sebastiandure33-crypto/Banco-de-pruebas-PID-v2/1_DISENO_3D/imagenes/01_vista_general.png

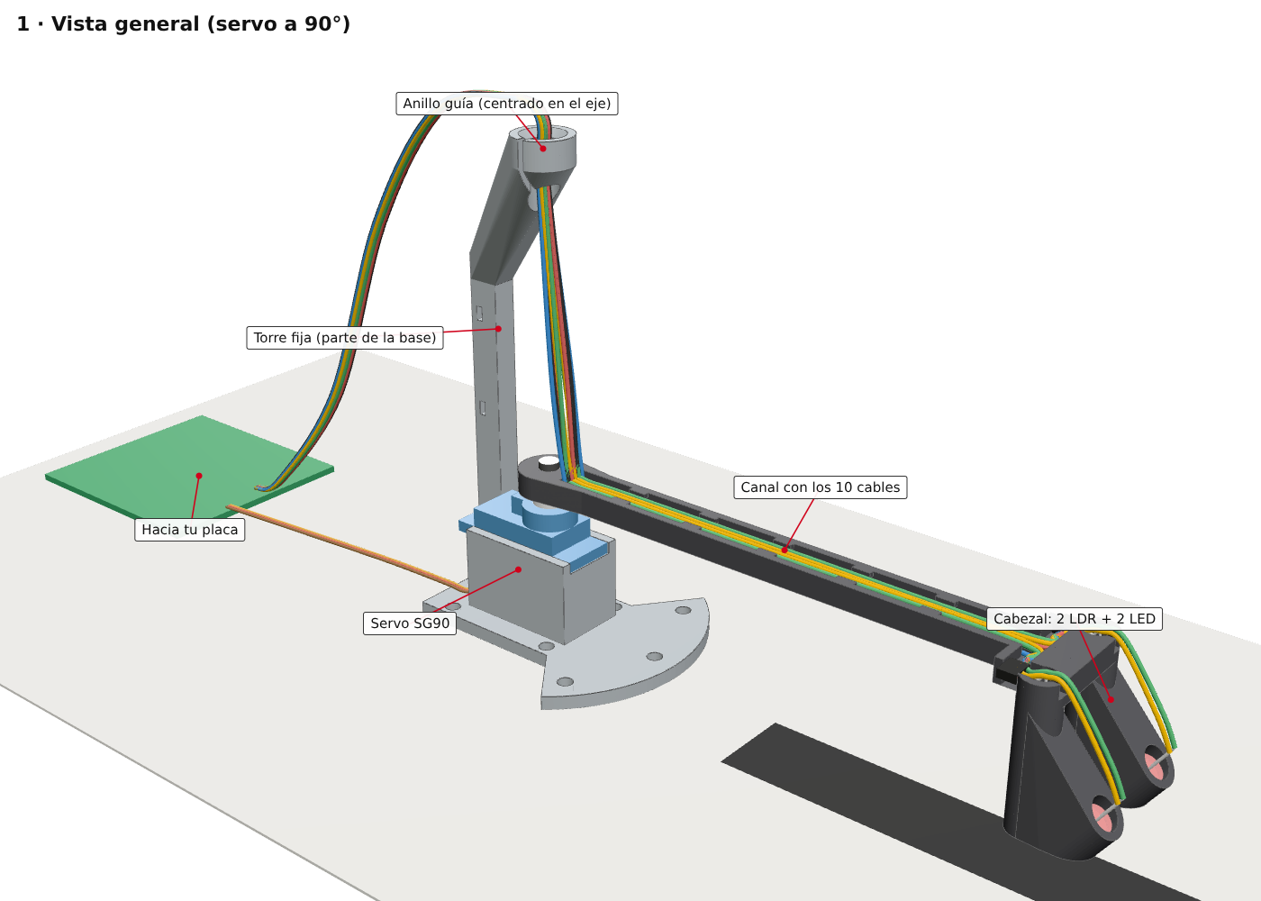
1_DISENO_3D/imagenes/01_vista_general.png
