sebastiandure33-crypto/Banco-de-pruebas-PID-v2/1_DISENO_3D/imagenes/02_vista_lateral.png

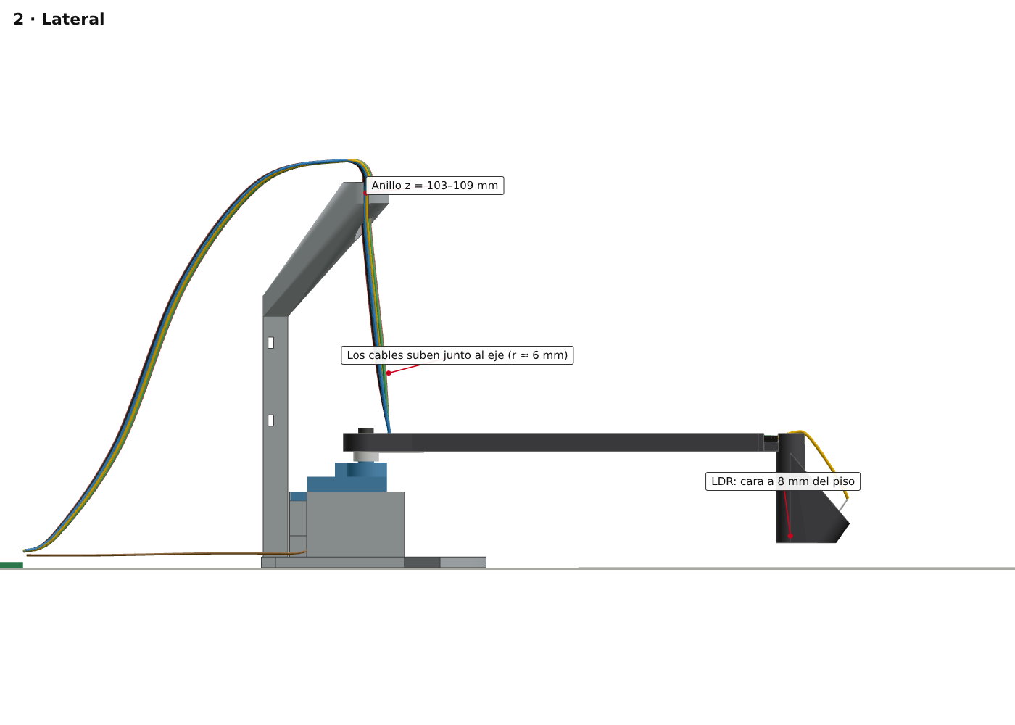
1_DISENO_3D/imagenes/02_vista_lateral.png
