sebastiandure33-crypto/Banco-de-pruebas-PID-v2/1_DISENO_3D/imagenes/04_cabezal.png

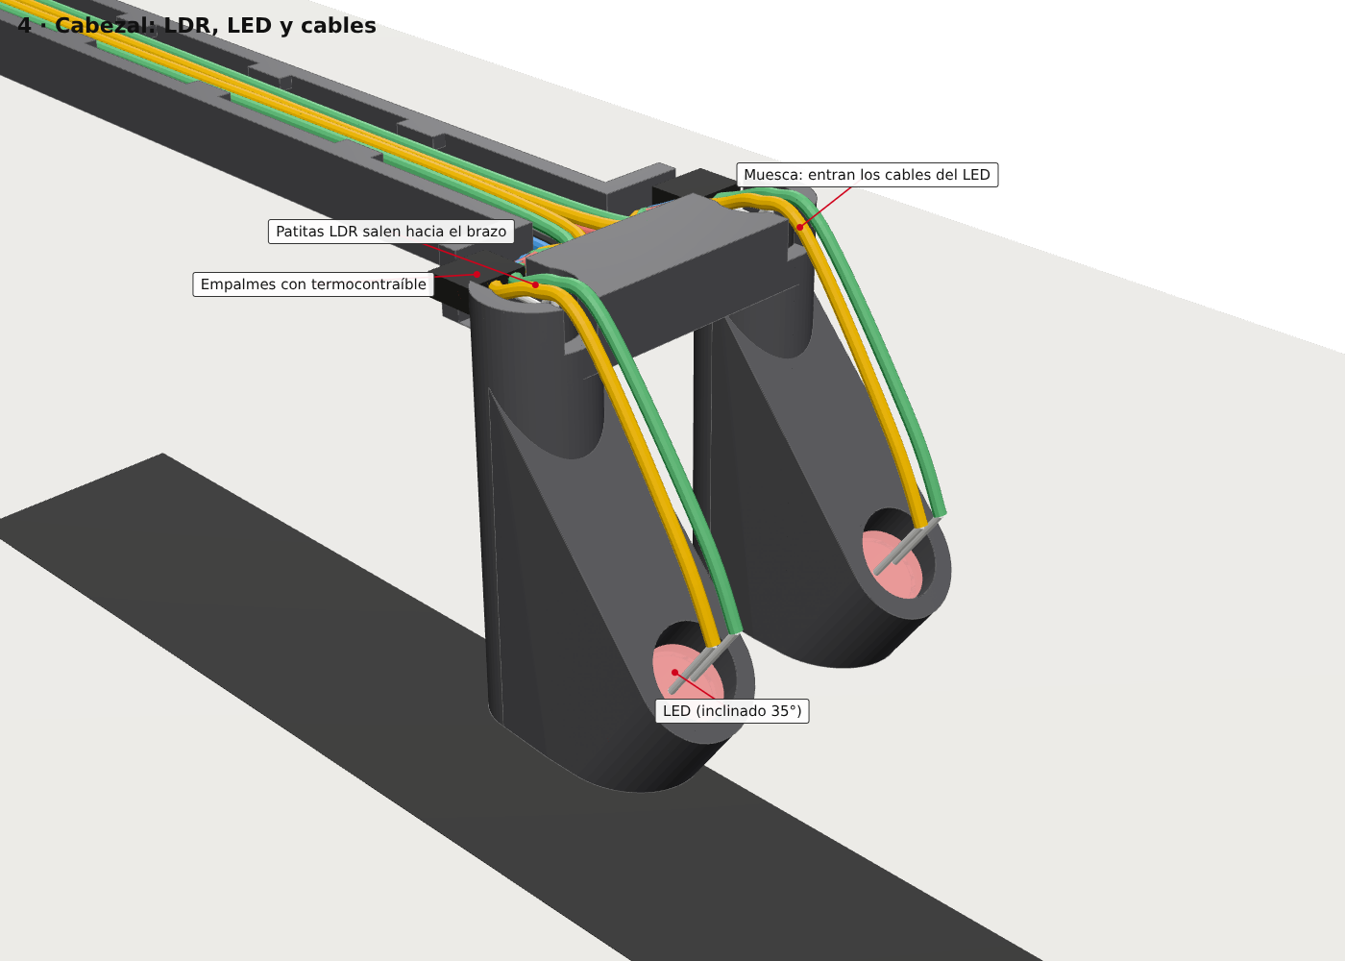
1_DISENO_3D/imagenes/04_cabezal.png
