sebastiandure33-crypto/Banco-de-pruebas-PID-v2/1_DISENO_3D/imagenes/05_cabezal_desde_abajo.png

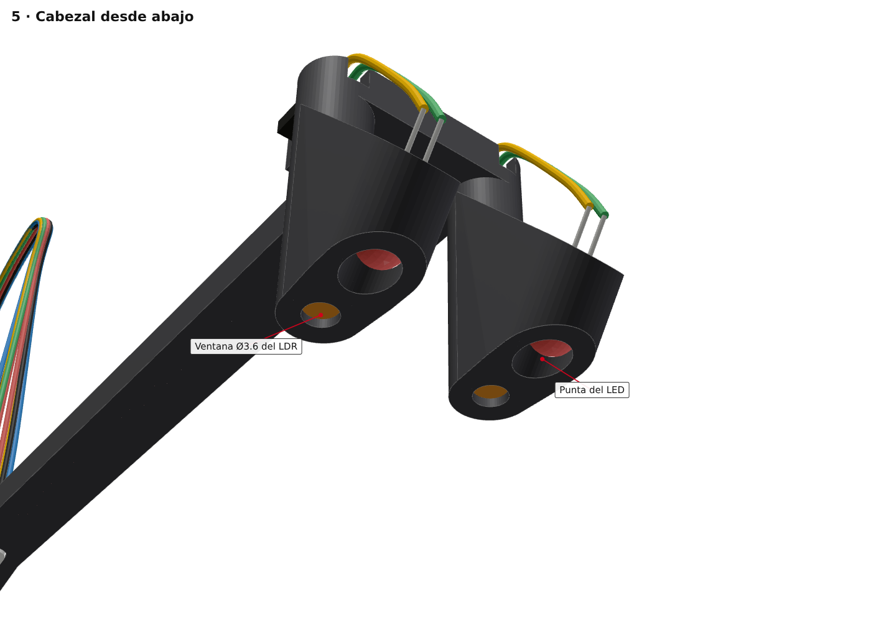
1_DISENO_3D/imagenes/05_cabezal_desde_abajo.png
