sebastiandure33-crypto/Banco-de-pruebas-PID-v2/1_DISENO_3D/imagenes/06_salida_cables_anillo.png

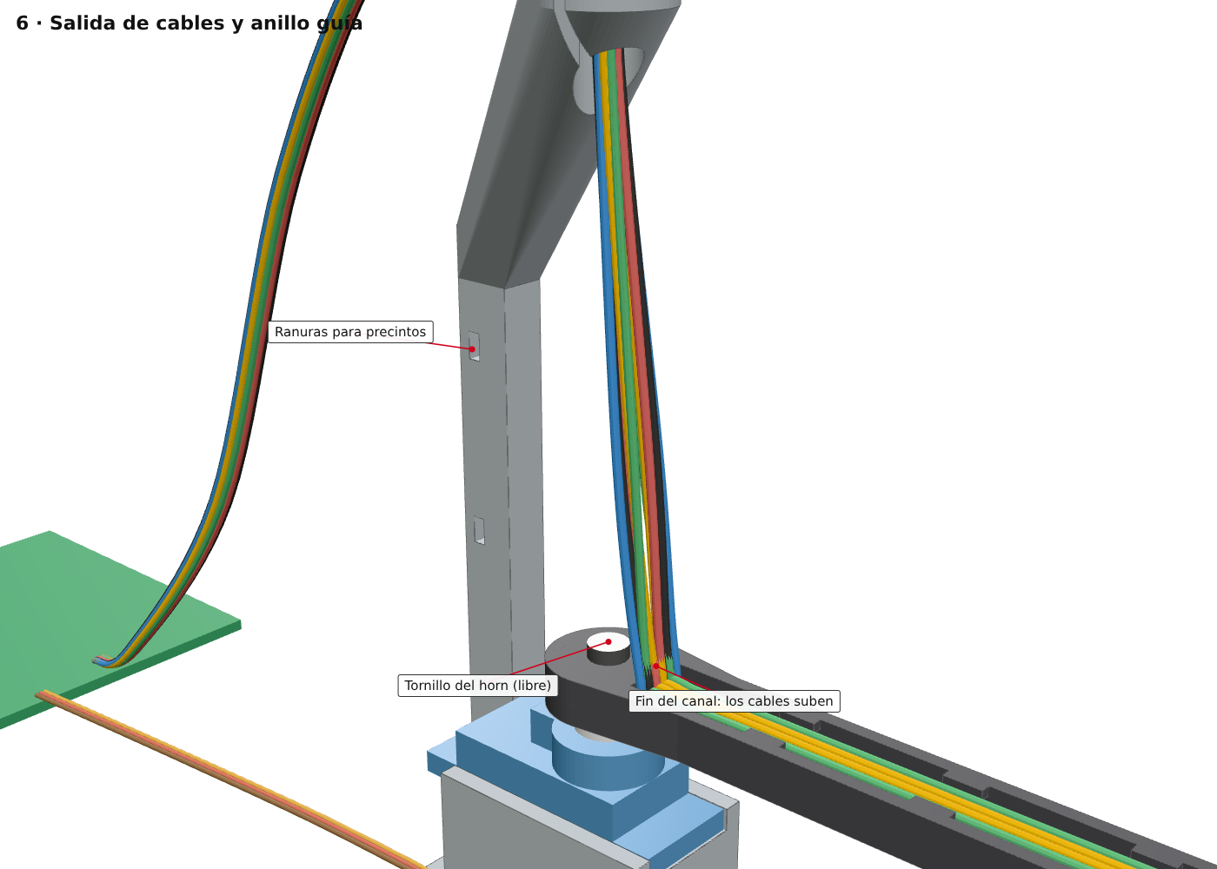
1_DISENO_3D/imagenes/06_salida_cables_anillo.png
