sebastiandure33-crypto/Banco-de-pruebas-PID-v2/1_DISENO_3D/imagenes/07_corte_3D_cabina.png

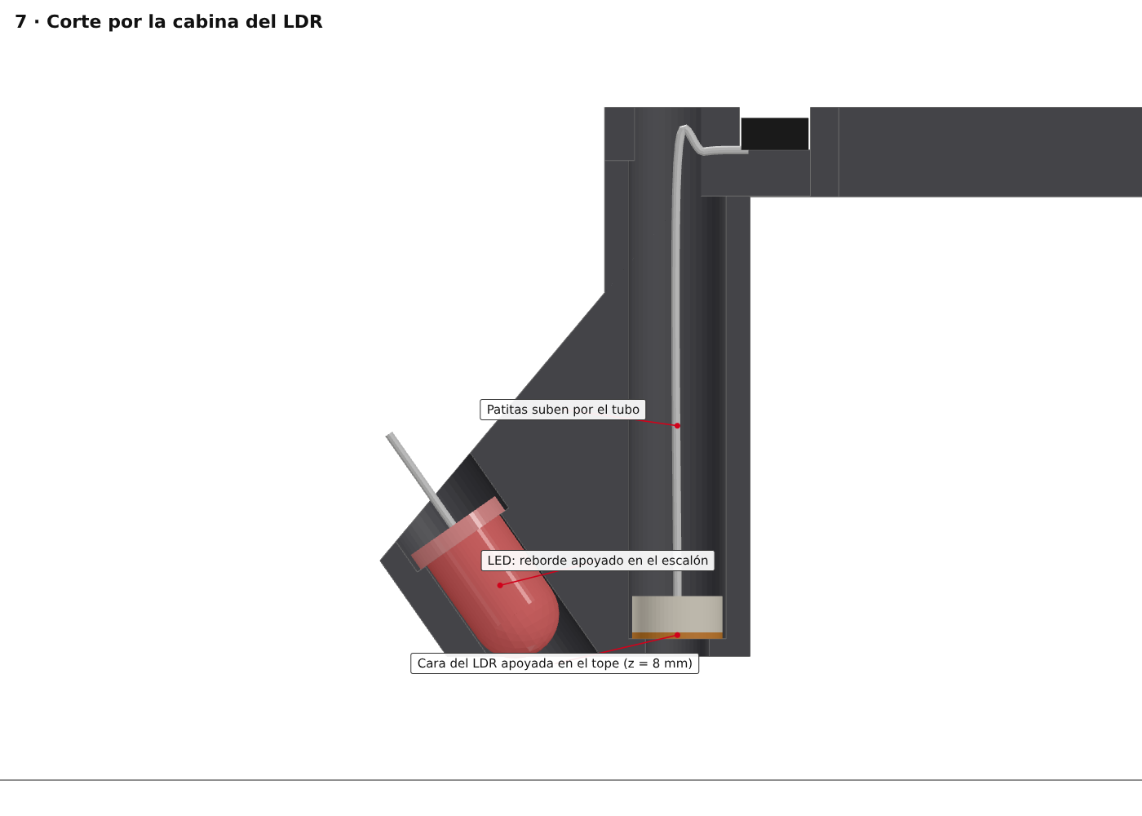
1_DISENO_3D/imagenes/07_corte_3D_cabina.png
