sebastiandure33-crypto/Banco-de-pruebas-PID-v2/1_DISENO_3D/imagenes/08_corte_cabina_LDR_acotado.png

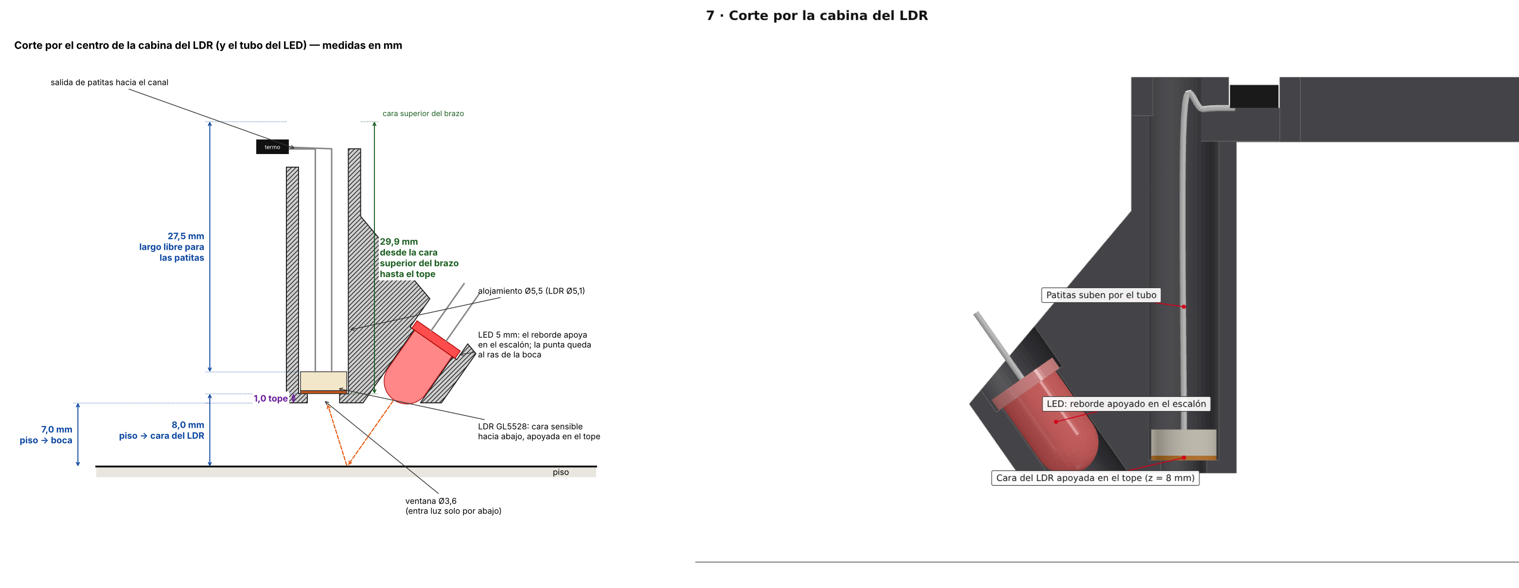
1_DISENO_3D/imagenes/08_corte_cabina_LDR_acotado.png
