sebastiandure33-crypto/Banco-de-pruebas-PID-v2/1_DISENO_3D/imagenes/09_orientacion_de_impresion.png

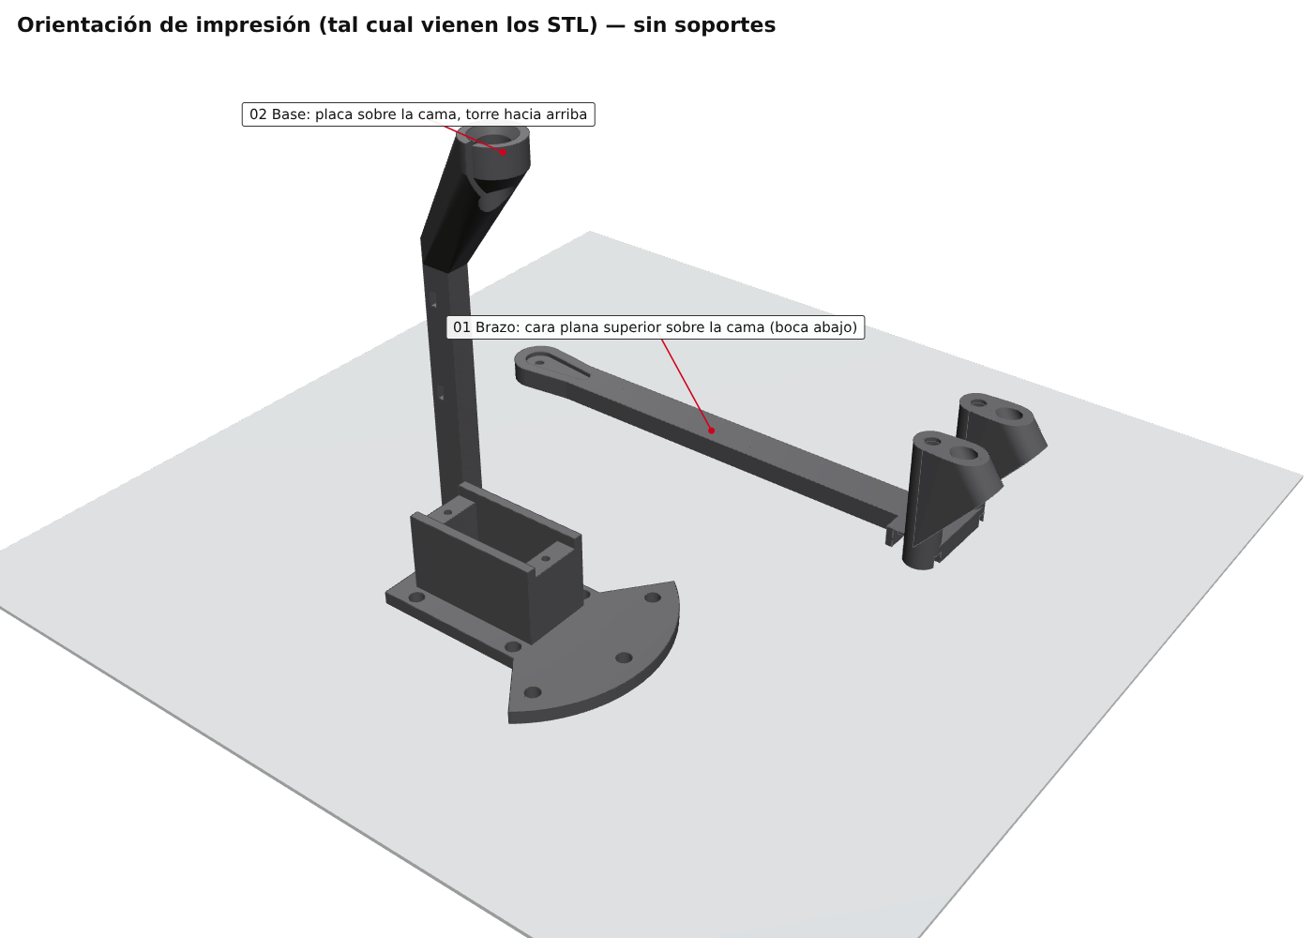
1_DISENO_3D/imagenes/09_orientacion_de_impresion.png
