sebastiandure33-crypto/Banco-de-pruebas-PID-v2/1_DISENO_3D/imagenes/11_ranura_cable_servo.png

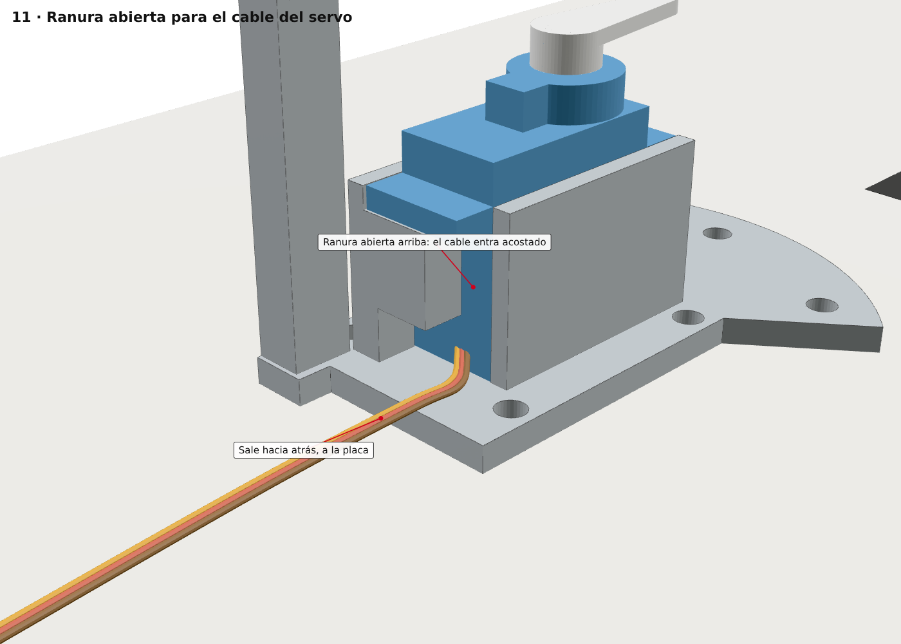
1_DISENO_3D/imagenes/11_ranura_cable_servo.png
