sebastiandure33-crypto/Banco-de-pruebas-PID-v2/1_DISENO_3D/imagenes/13_plataforma_superior.png

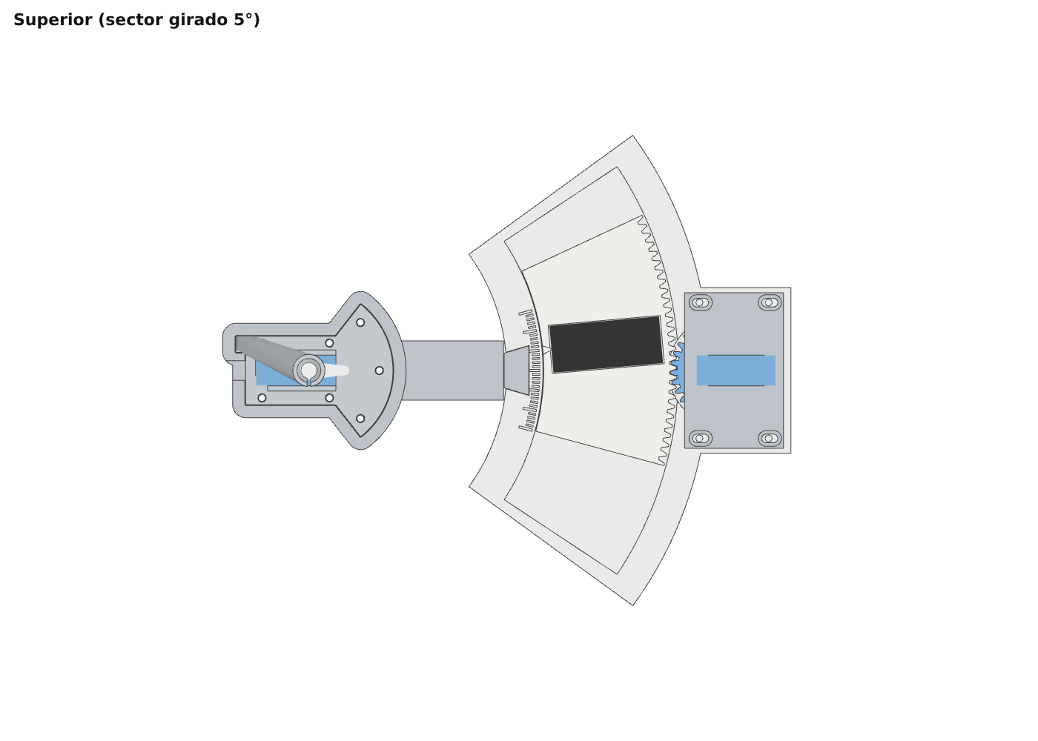
1_DISENO_3D/imagenes/13_plataforma_superior.png
