sebastiandure33-crypto/Banco-de-pruebas-PID-v2/1_DISENO_3D/imagenes/14_pinon_y_soporte.png

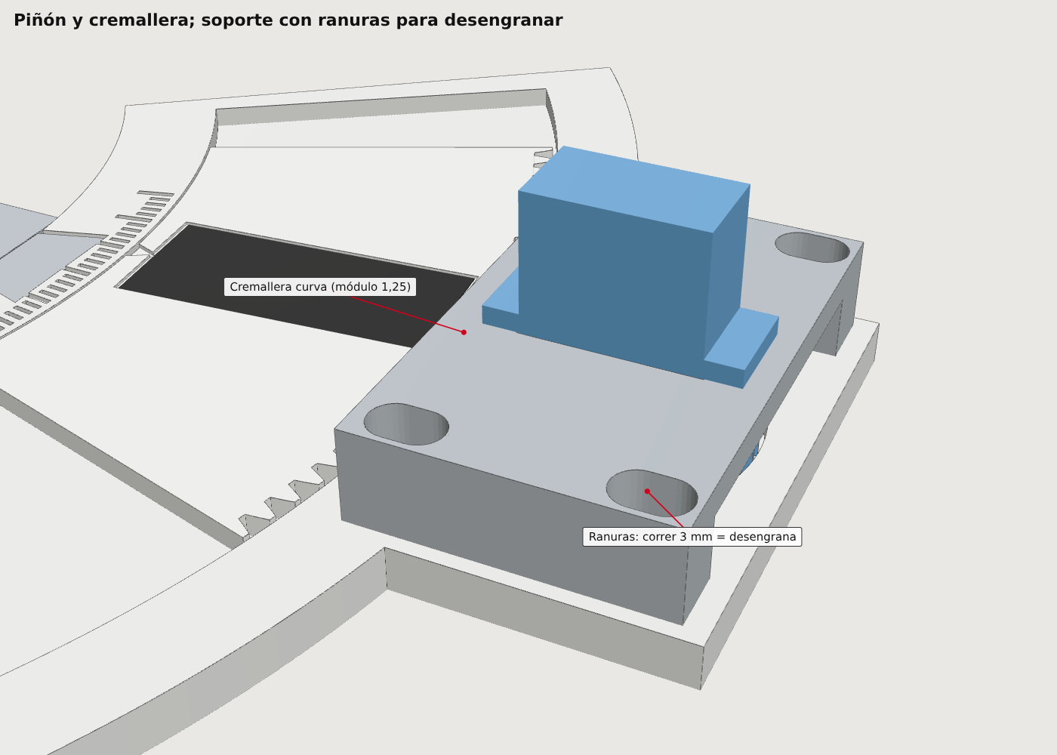
1_DISENO_3D/imagenes/14_pinon_y_soporte.png
