sebastiandure33-crypto/Banco-de-pruebas-PID-v2/1_DISENO_3D/imagenes/15_pinon_horns.png

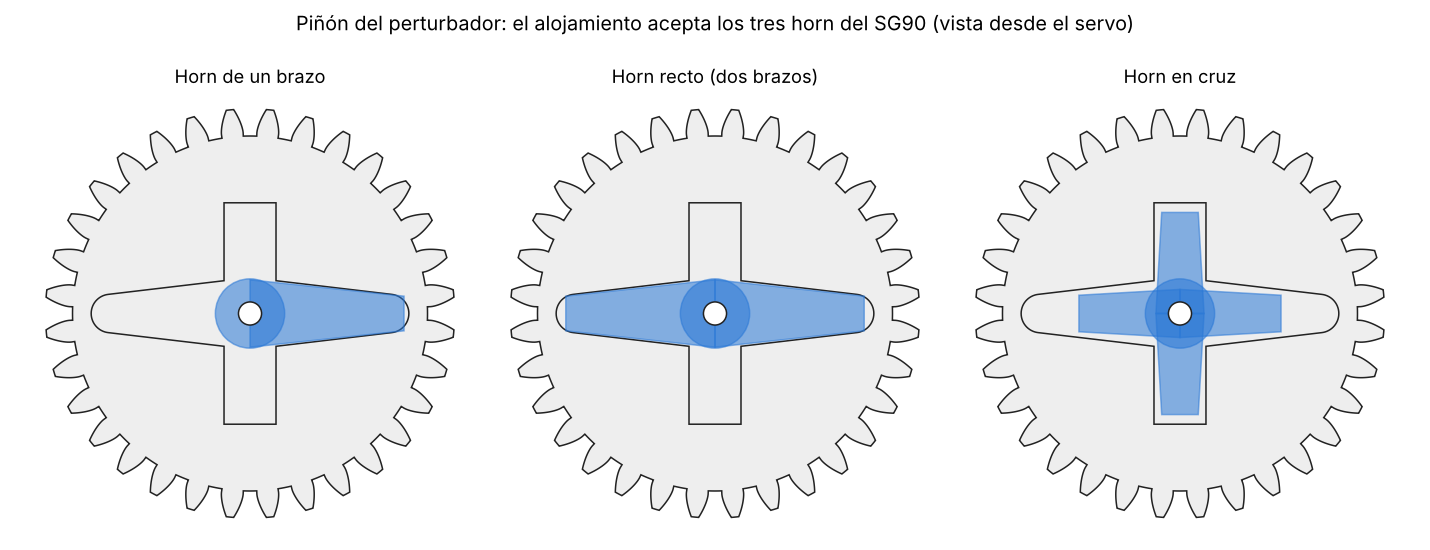
1_DISENO_3D/imagenes/15_pinon_horns.png
