sebastiandure33-crypto/Banco-de-pruebas-PID-v2/2_PLANOS/hoja1_servo.png

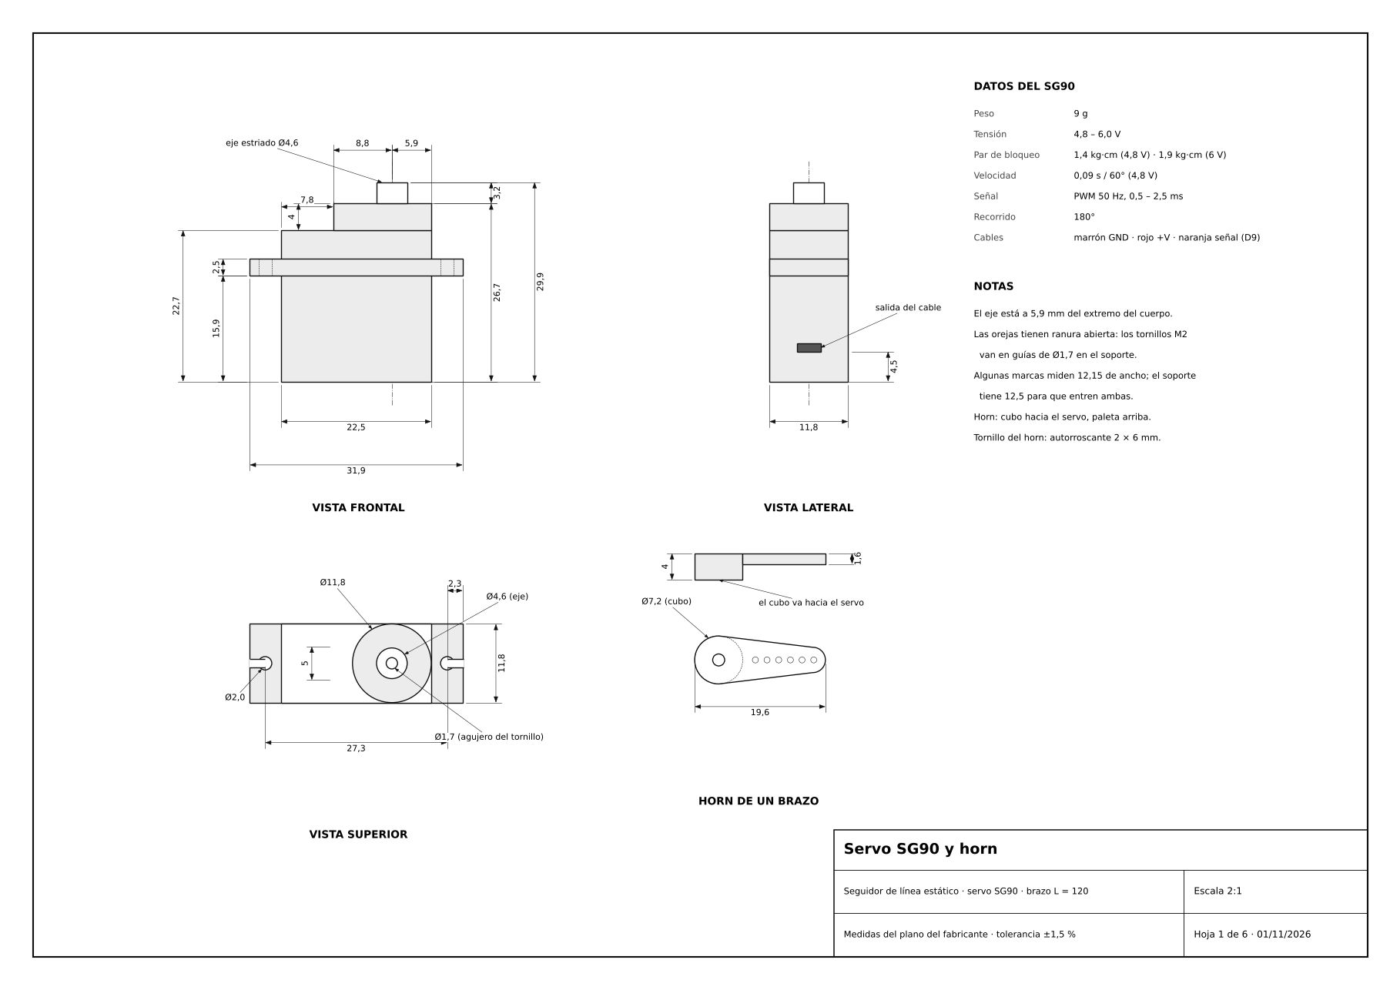
2_PLANOS/hoja1_servo.png
