sebastiandure33-crypto/Banco-de-pruebas-PID-v2/2_PLANOS/hoja2_soporte.png

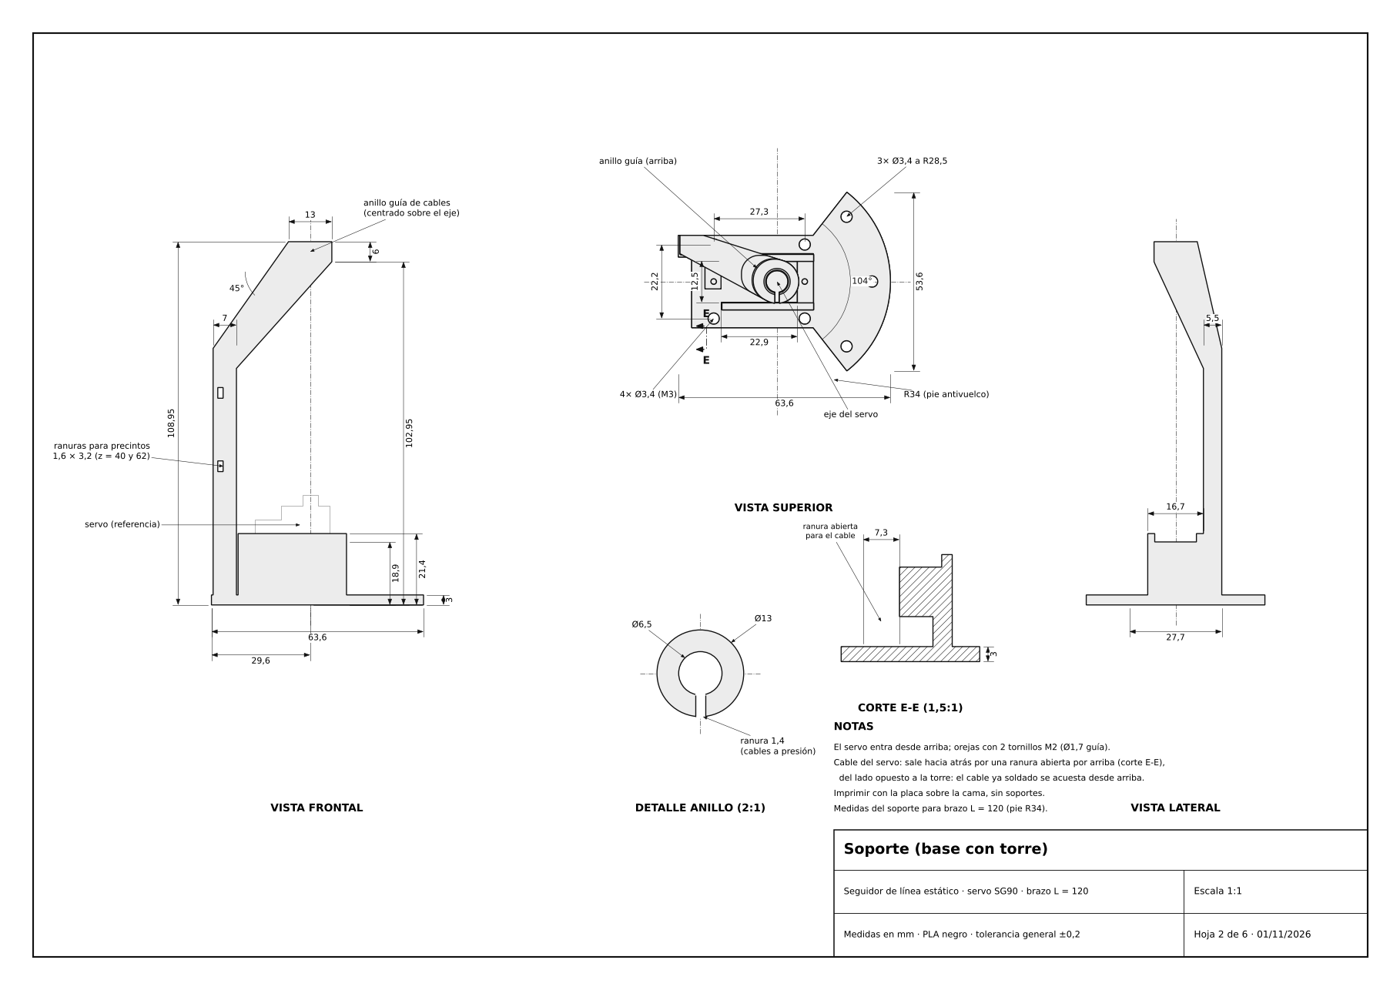
2_PLANOS/hoja2_soporte.png
