sebastiandure33-crypto/Banco-de-pruebas-PID-v2/2_PLANOS/hoja3_brazo.png

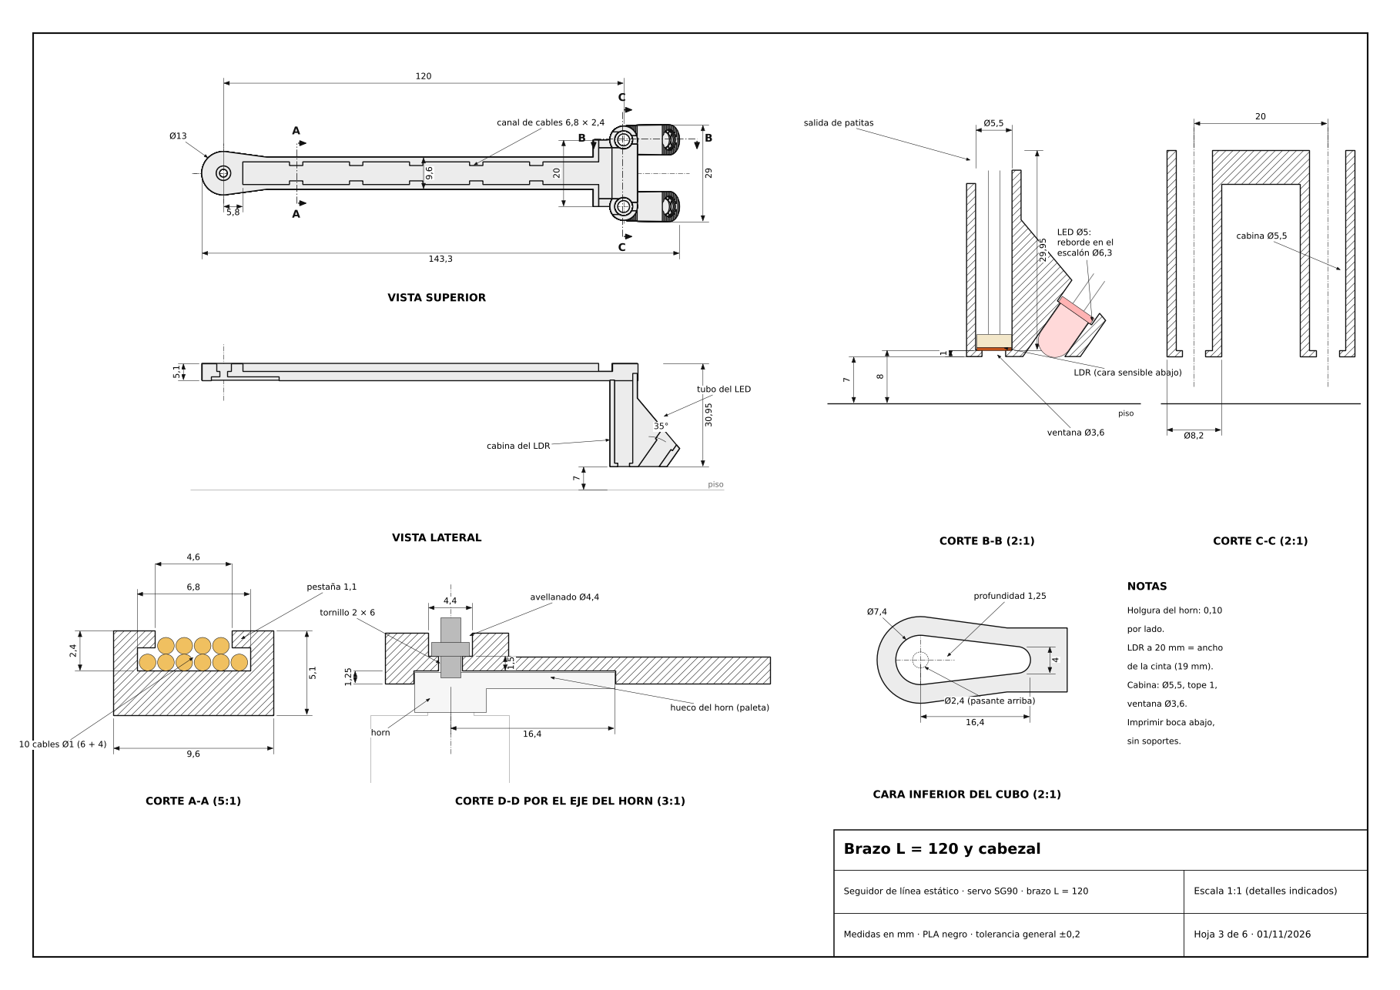
2_PLANOS/hoja3_brazo.png
