sebastiandure33-crypto/Banco-de-pruebas-PID-v2/2_PLANOS/hoja4_conjunto.png

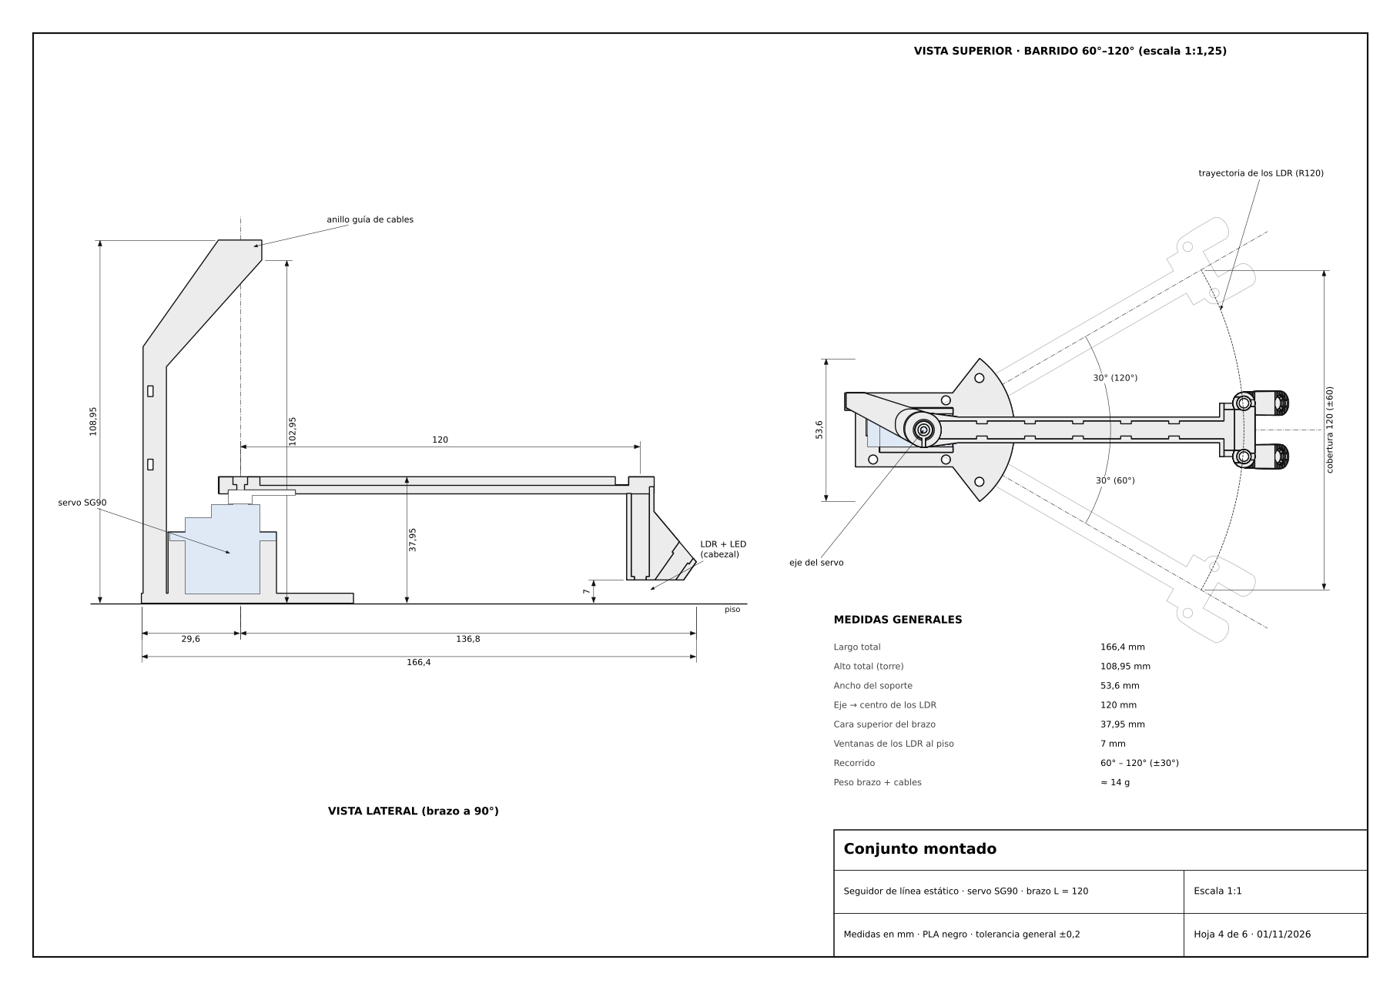
2_PLANOS/hoja4_conjunto.png
