sebastiandure33-crypto/Banco-de-pruebas-PID-v2/2_PLANOS/hoja5_esquema.png

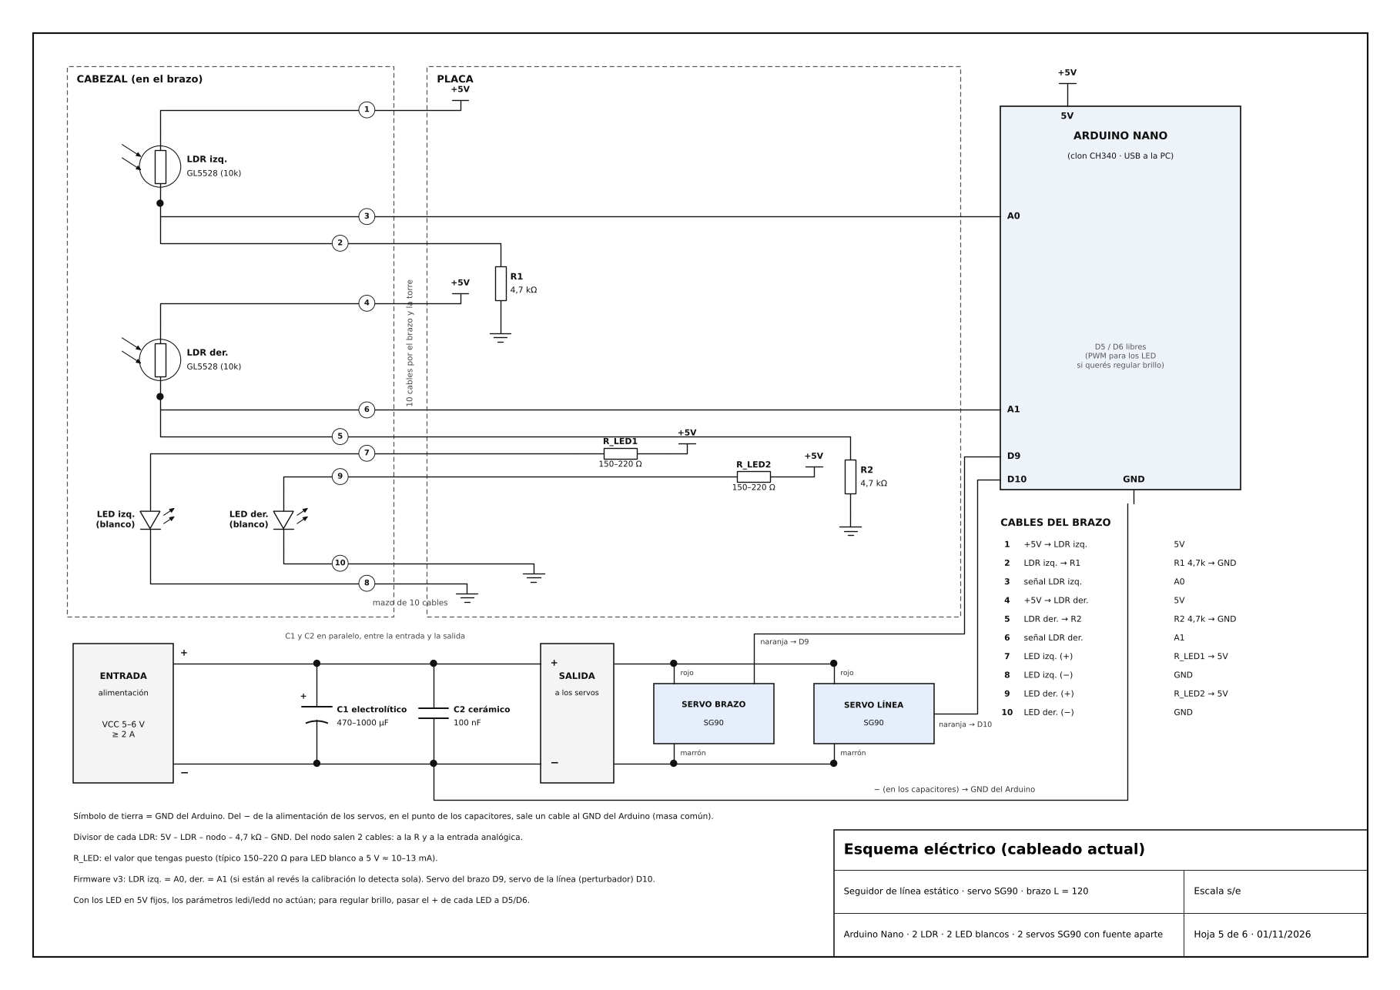
2_PLANOS/hoja5_esquema.png
