sebastiandure33-crypto/Banco-de-pruebas-PID-v2/2_PLANOS/hoja6_plataforma.png

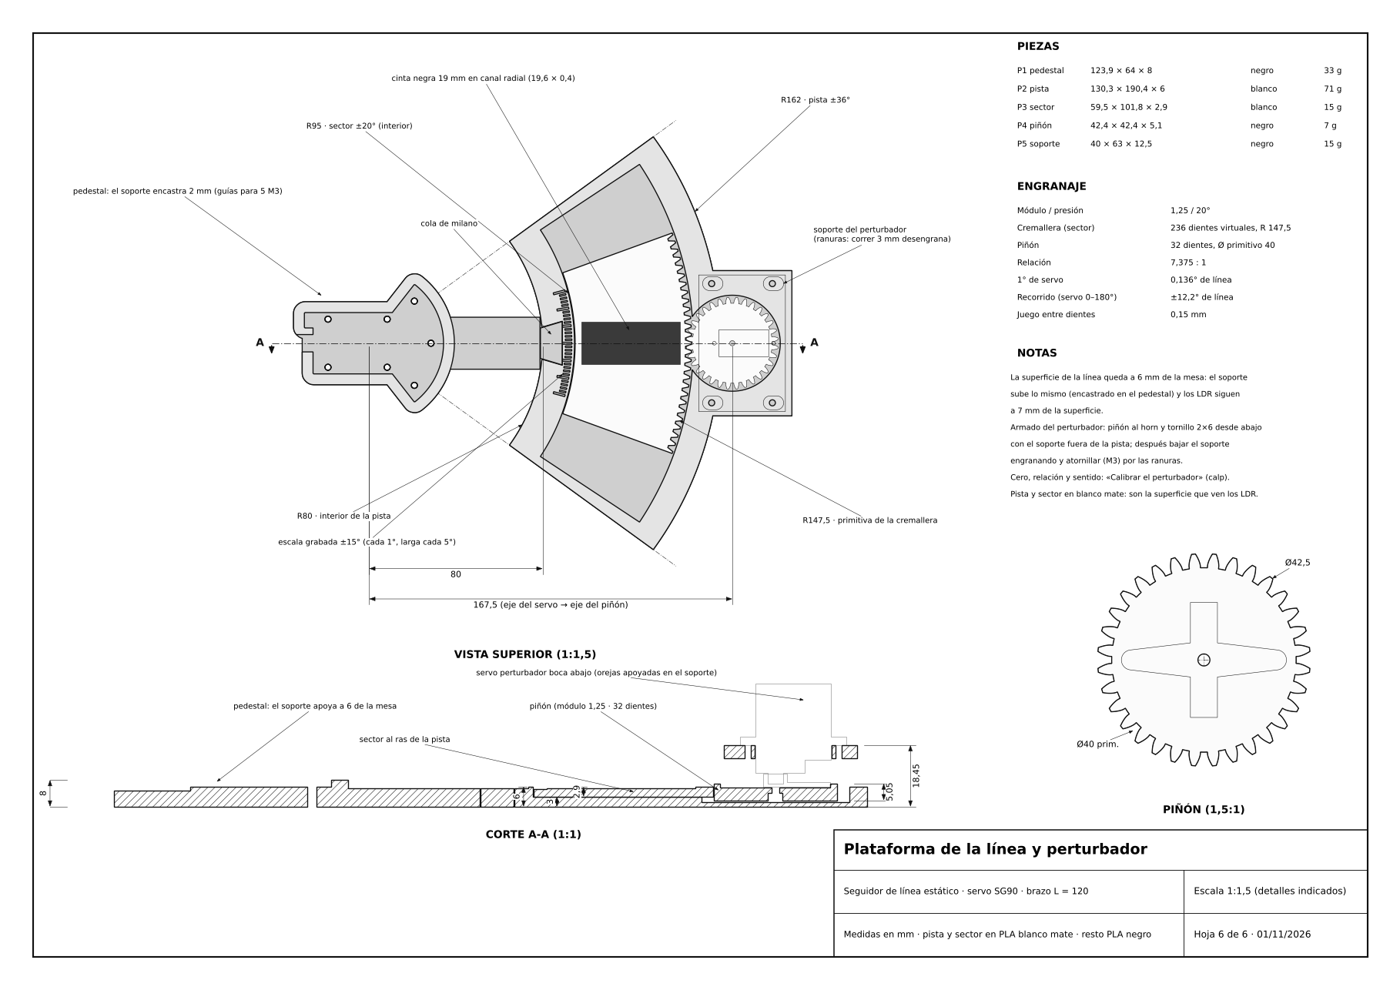
2_PLANOS/hoja6_plataforma.png
