sebastiandure33-crypto/Banco-de-pruebas-PID-v2/1_DISENO_3D/impresion/06_pinon.stl

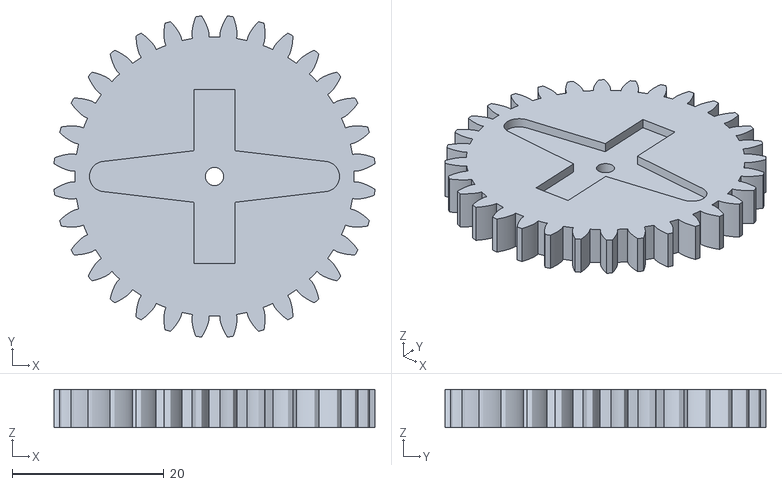
[picture p21: CAD file, 2026-11-02]
1_DISENO_3D/impresion/06_pinon.stl
42.4 x 42.4 x 5.05
