sebastiandure33-crypto/Banco-de-pruebas-PID-v2/1_DISENO_3D/variantes/base_apoyo_libre_L100.stl

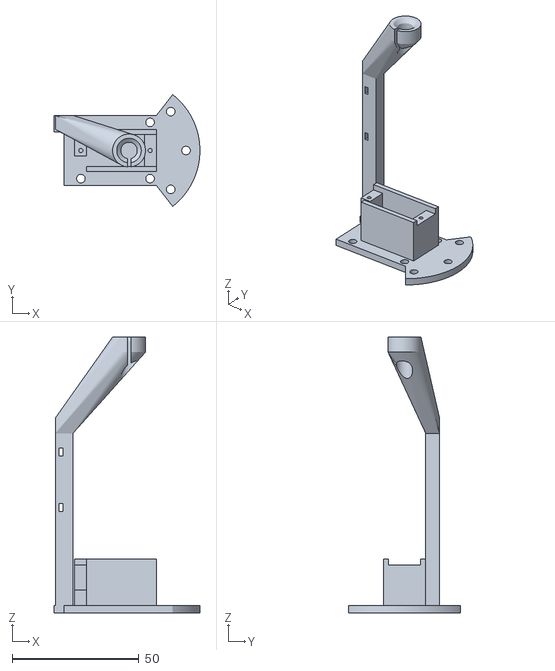
[picture p22: CAD file, 2026-11-01]
1_DISENO_3D/variantes/base_apoyo_libre_L100.stl
57.6 x 44.1 x 108.9
