sebastiandure33-crypto/Banco-de-pruebas-PID-v2/1_DISENO_3D/impresion/03_pedestal.stl

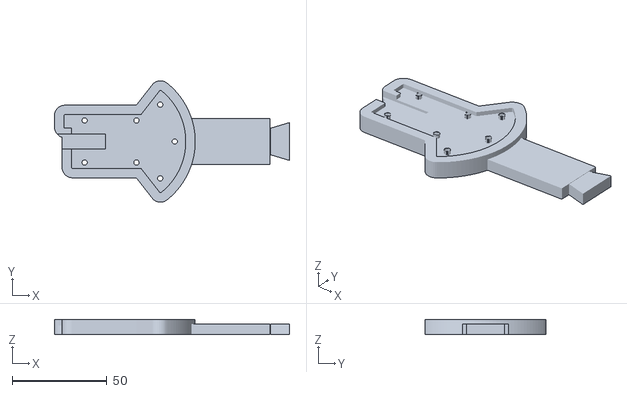
[picture p23: CAD file, 2026-11-01]
1_DISENO_3D/impresion/03_pedestal.stl
123.9 x 64.0 x 8.00
