sebastiandure33-crypto/Banco-de-pruebas-PID-v2/1_DISENO_3D/variantes/base_apoyo_libre_L120.stl

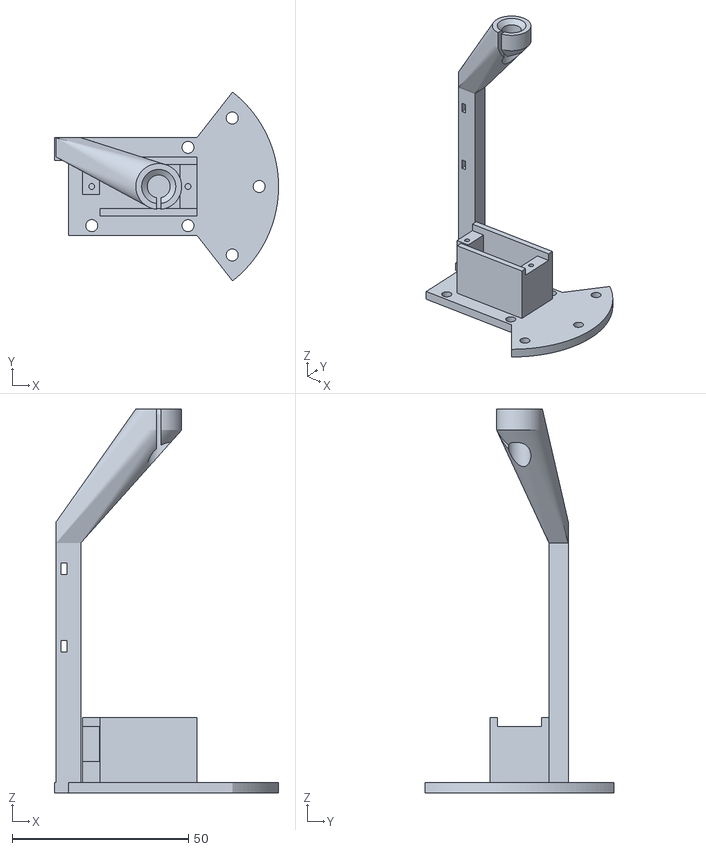
[picture p24: CAD file, 2026-11-01]
1_DISENO_3D/variantes/base_apoyo_libre_L120.stl
63.6 x 53.6 x 108.9
