sebastiandure33-crypto/Banco-de-pruebas-PID-v2/1_DISENO_3D/variantes/plataforma/P5_soporte_perturbador.stl

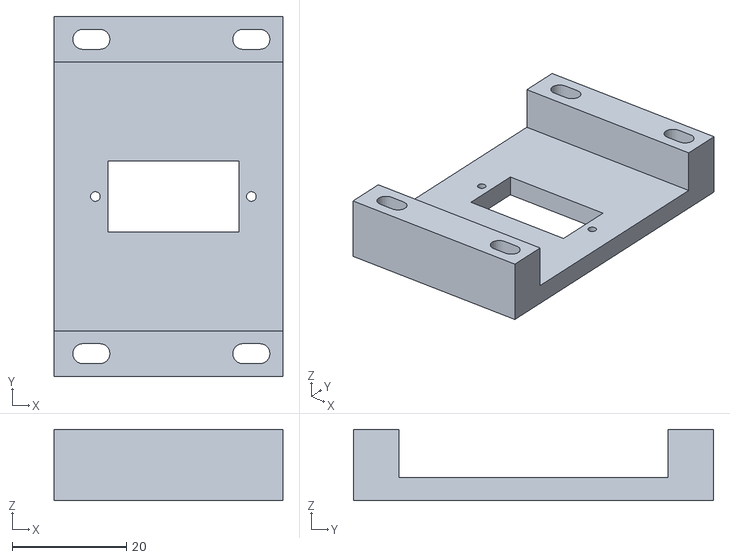
[picture p25: CAD file, 2026-11-01]
1_DISENO_3D/variantes/plataforma/P5_soporte_perturbador.stl
40.0 x 63.0 x 12.4
