sebastiandure33-crypto/Banco-de-pruebas-PID-v2/1_DISENO_3D/impresion/05_sector_linea_BLANCO.stl

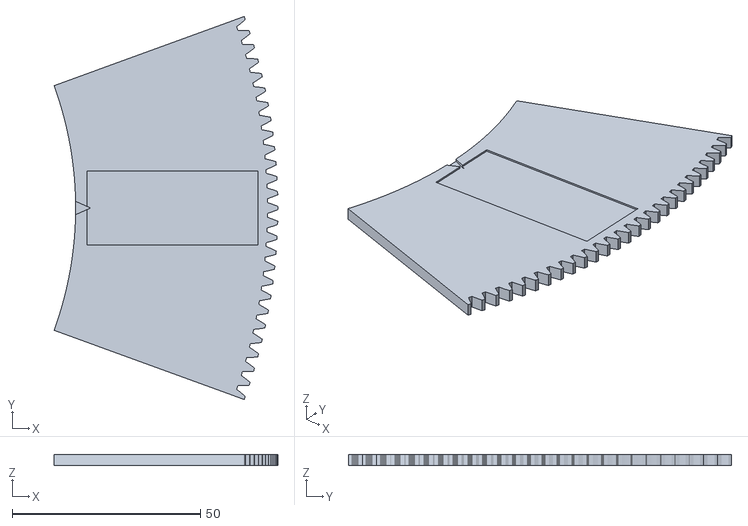
[picture p26: CAD file, 2026-11-01]
1_DISENO_3D/impresion/05_sector_linea_BLANCO.stl
59.5 x 101.8 x 2.90
