sebastiandure33-crypto/Banco-de-pruebas-PID-v2/1_DISENO_3D/variantes/base_compacta_atornillar.stl

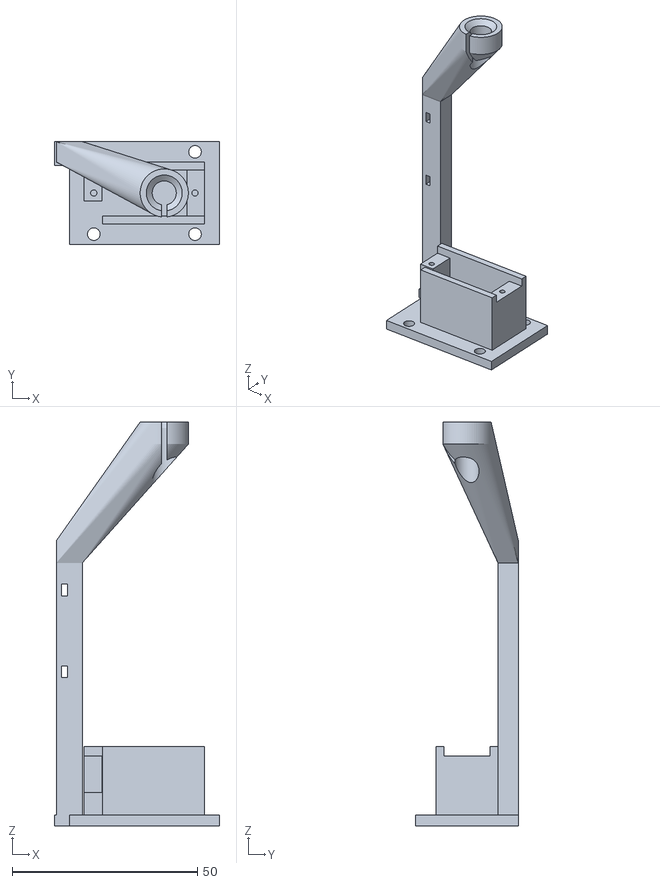
[picture p28: CAD file, 2026-11-01]
1_DISENO_3D/variantes/base_compacta_atornillar.stl
44.5 x 27.7 x 108.9
