sebastiandure33-crypto/Banco-de-pruebas-PID-v2/1_DISENO_3D/impresion/04_pista_BLANCO.stl

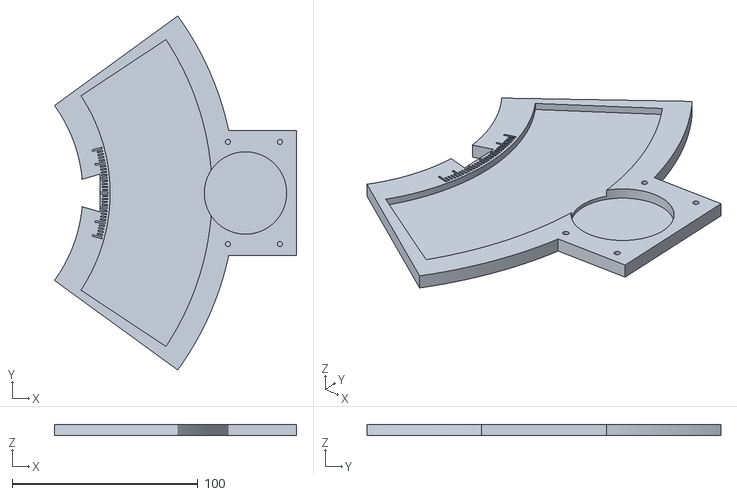
[picture p29: CAD file, 2026-11-01]
1_DISENO_3D/impresion/04_pista_BLANCO.stl
130.3 x 190.4 x 6.00
