sebastiandure33-crypto/Banco-de-pruebas-PID-v2/1_DISENO_3D/variantes/base_apoyo_libre_L150.stl

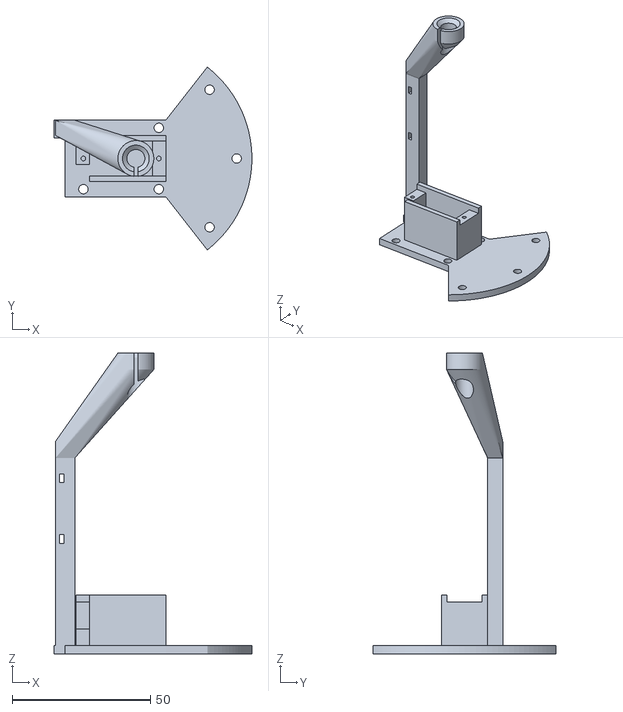
[picture p30: CAD file, 2026-11-01]
1_DISENO_3D/variantes/base_apoyo_libre_L150.stl
71.6 x 66.2 x 108.9
