sebastiandure33-crypto/Banco-de-pruebas-PID-v2/1_DISENO_3D/impresion/01_brazo_L120.stl

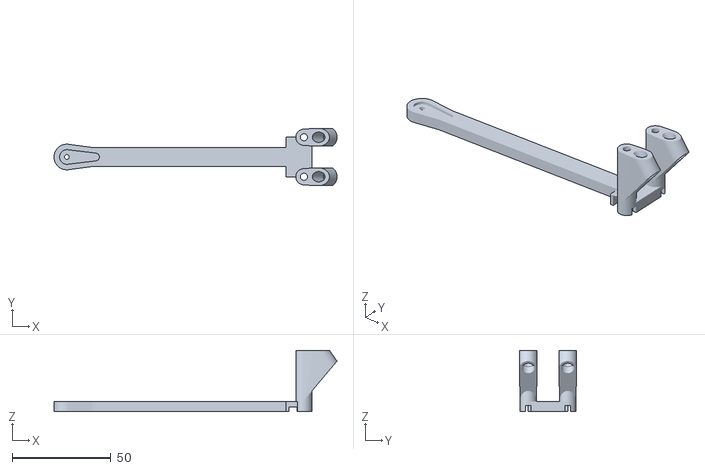
[picture p31: CAD file, 2026-11-01]
1_DISENO_3D/impresion/01_brazo_L120.stl
143.3 x 29.0 x 31.0
