sebastiandure33-crypto/Banco-de-pruebas-PID-v2/1_DISENO_3D/variantes/brazo_L150.stl

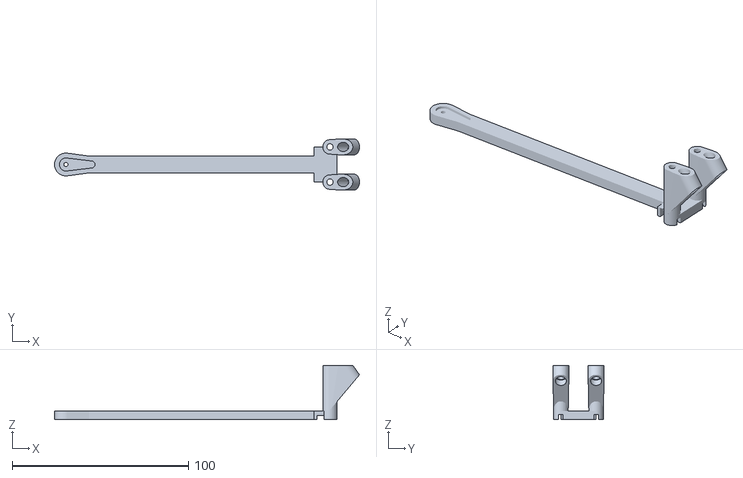
[picture p32: CAD file, 2026-11-01]
1_DISENO_3D/variantes/brazo_L150.stl
173.3 x 29.0 x 31.0
