sebastiandure33-crypto/Banco-de-pruebas-PID-v2/1_DISENO_3D/imagenes/00_lamina_ensamble.png

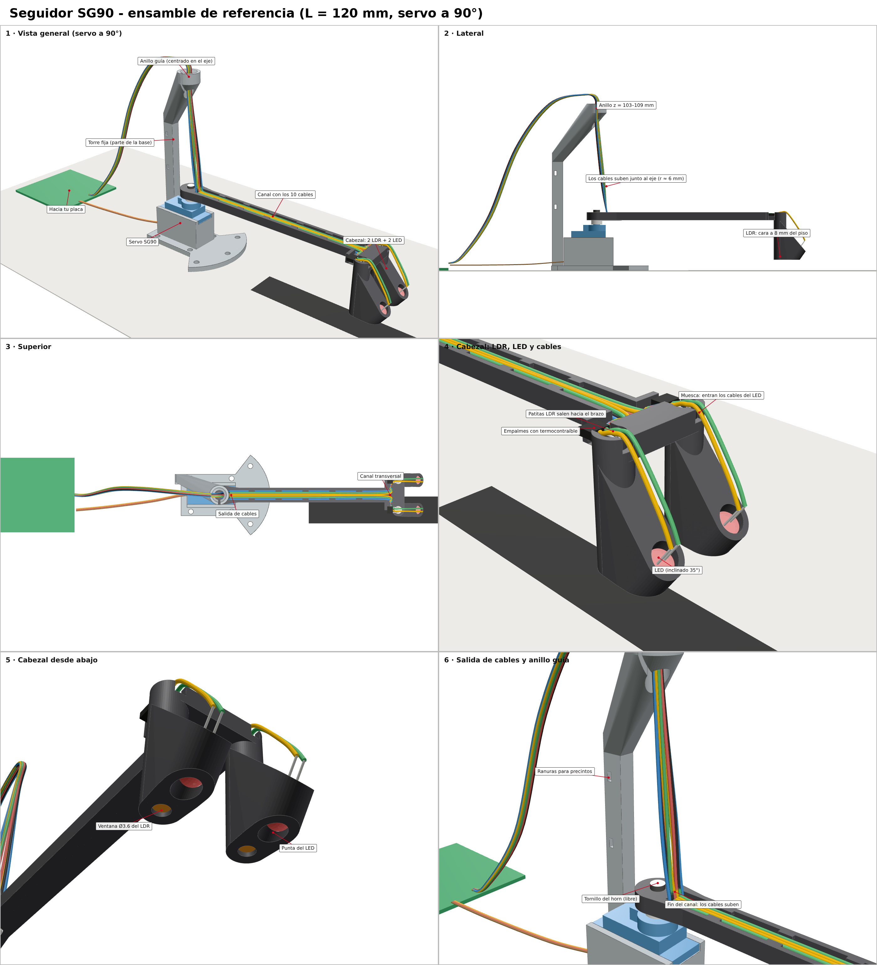
1_DISENO_3D/imagenes/00_lamina_ensamble.png
