sebastiandure33-crypto/Banco-de-pruebas-PID-v2/1_DISENO_3D/imagenes/10_montaje_horn_brazo_tornillo.png

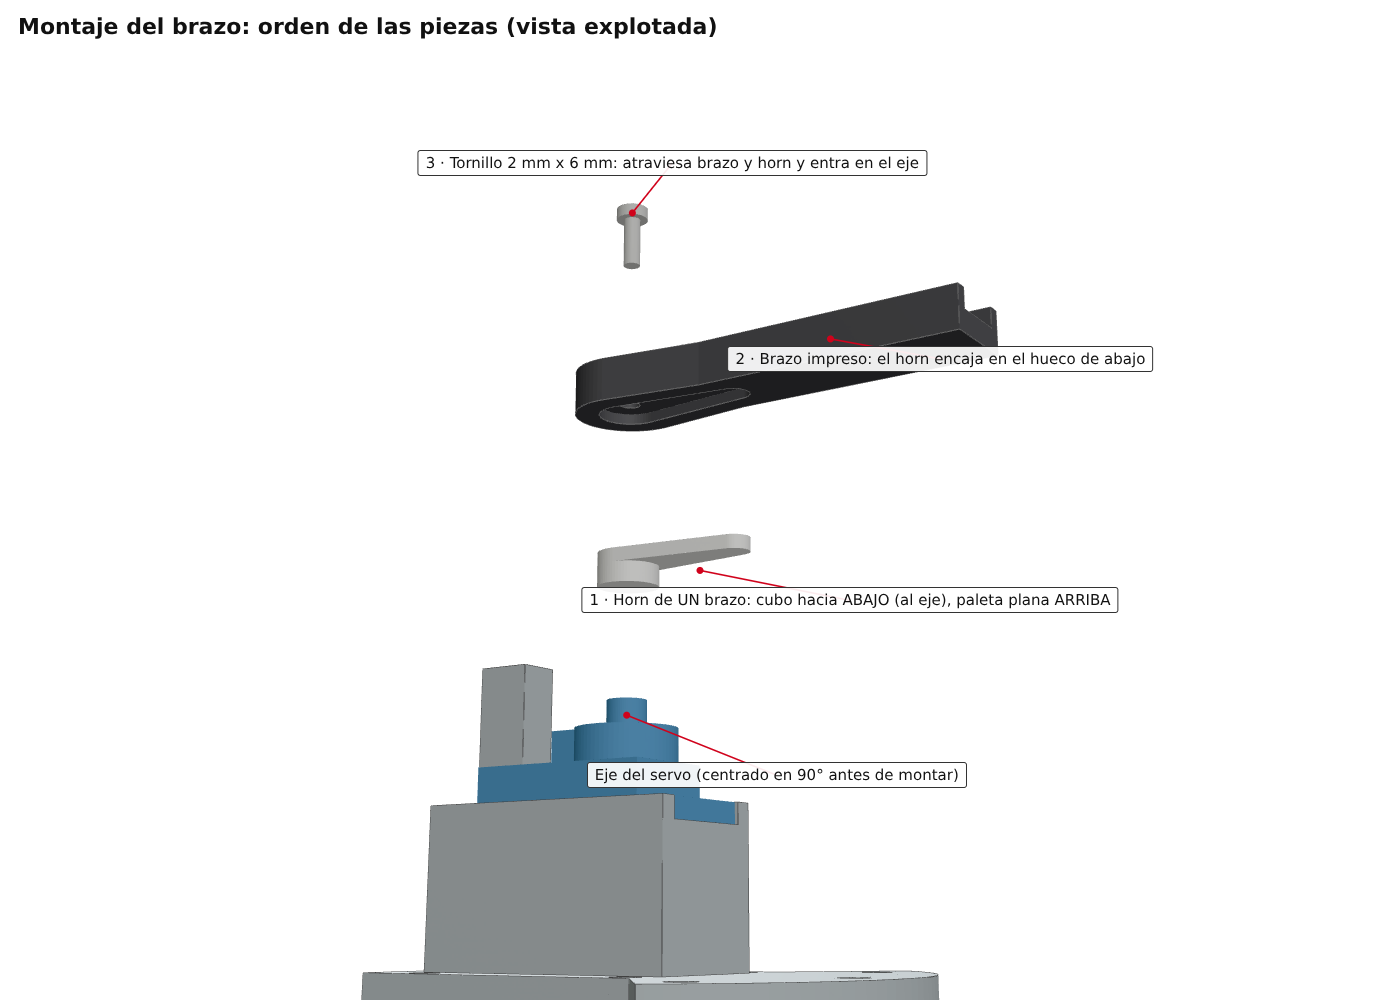
1_DISENO_3D/imagenes/10_montaje_horn_brazo_tornillo.png
