sebastiandure33-crypto/Banco-de-pruebas-PID-v2/3_FIRMWARE_Y_PANEL/pruebas_simulacion/resultado_sistema_x3.txt

== ARRANQUE ==
  [  0.302] BOOT,banco_pid,3.0,desconocida,config de fabrica
  [  0.302] I,get set run stop cal calp goto lin lcero ens save load defaults tel status
  [  0.302] ST,REPOSO,0,0,0,90.00,0,0.00,0
  OK   mensaje de arranque
  crudo sobre blanco: izq=768 der=300 (izquierdo casi saturado, a proposito)
== CALIBRACION DEL BRAZO (cal) ==
  C,DIAG,5.02,4.77,788,483,88.0,97.4,9.4
  C,OK,89.00,0.7529,1.78
  OK   calibracion exitosa
  OK   desfase entre LDR medido (~9,5°)
  linea real en 89.00°, calibracion dice 89.00°
  OK   centro calibrado a menos de 1° del real
== CALIBRACION DEL PERTURBADOR (calp) ==
  CP,OK,85.80,7.043,-1,1.047,1,0.45
  OK   calp exitosa
  OK   detecto el sentido invertido del engranaje
  OK   corrigio la relacion real (7,2) a menos de 4 %
  con lin=0 la linea queda en 89.67° del servo del brazo (se pidio 90° + horn -2.5°)
  OK   cero de la linea bajo el brazo en 90° (servo)
== PI POR DEFECTO, LINEA QUIETA ==
  error medio -0.03°, pico a pico 0.00°
  OK   centrado y sin bucle
== MODO P: ERROR DE REGIMEN (didactico) ==
  P puro kp=1 con la linea a 4° de u0: error de regimen -2.44° (teoria ~ -2°)
  OK   P puro deja error de regimen
  PI: error 0.11°
  OK   PI elimina el error de regimen
== PID CON DERIVATIVO ==
  PID: error 0.11°, pico a pico 0.00°
  OK   PID estable
== ENSAYOS CON EL LAZO CERRADO ==
  ens pesc 3
      fin=si  telemetria=225 lineas  sobrepaso 39 %  establecimiento 1.20 s  error final 0.16°
  OK   pesc
  OK     ...llega sin error final
  ens pesc -3
     fin=si  telemetria=225 lineas  sobrepaso 39 %  establecimiento 1.14 s  error final -0.05°
  OK   pesc
  OK     ...llega sin error final
  ens resc 1.5
    fin=si  telemetria=225 lineas  sobrepaso 0 %  establecimiento 3.94 s  error final -0.25°
  OK   resc
  OK     ...llega sin error final
  ens pram 4 2
    fin=si  telemetria=225 lineas
  OK   pram
  ens psen 2 0,5
  fin=si  telemetria=524 lineas
  OK   psen
== ESCALON DEL SERVO A LAZO ABIERTO (sesc) ==
  servo solo: sobrepaso 0 %, establecimiento 4.00 s, telemetria 225
  OK   sesc completo y vuelve a reposo
== INTERRUPTORES Y CORRECCION DE LDR ==
  OK   sigue con anti-windup, limite de velocidad y zona muerta apagados
  corr 0 (sin igualar): error medio -1.74°
  OK   modo manual (ganancia/offset) aceptado
== PERTURBACION MANUAL CON lin (lazo siguiendo) ==
  OK   sigue la linea movida por el perturbador
== ORDENES EN RAFAGA Y COMA DECIMAL ==
  OK   ordenes validas aplicadas (tambien con coma decimal)
  OK   ordenes invalidas rechazadas con mensaje
  OK   el control siguio durante la rafaga
== EEPROM ==
  OK   save/load restaura parametros y ambas calibraciones
  OK   EEPROM corrupta detectada por CRC
== SENSOR DESCONECTADO ==
  OK   falla detectada y control detenido
== CABEZAL MAL ARMADO (LDR uno detras del otro) ==
  C,DIAG,5.03,4.77,788,483,92.6,93.3,0.6
  ERR,cal,desfase LDR chico: la cinta debe apuntar al eje
  OK   la calibracion avisa que la cinta/sensores estan mal orientados

ciclos atrasados: 0   bytes/s promedio enviados: 1360 (maximo del puerto ~11500)
RESULTADO: 0 chequeos fallidos
