sebastiandure33-crypto/Banco-de-pruebas-PID-v2/2_PLANOS/Planos_Banco_PID.pdf

## DATOS DEL SG90

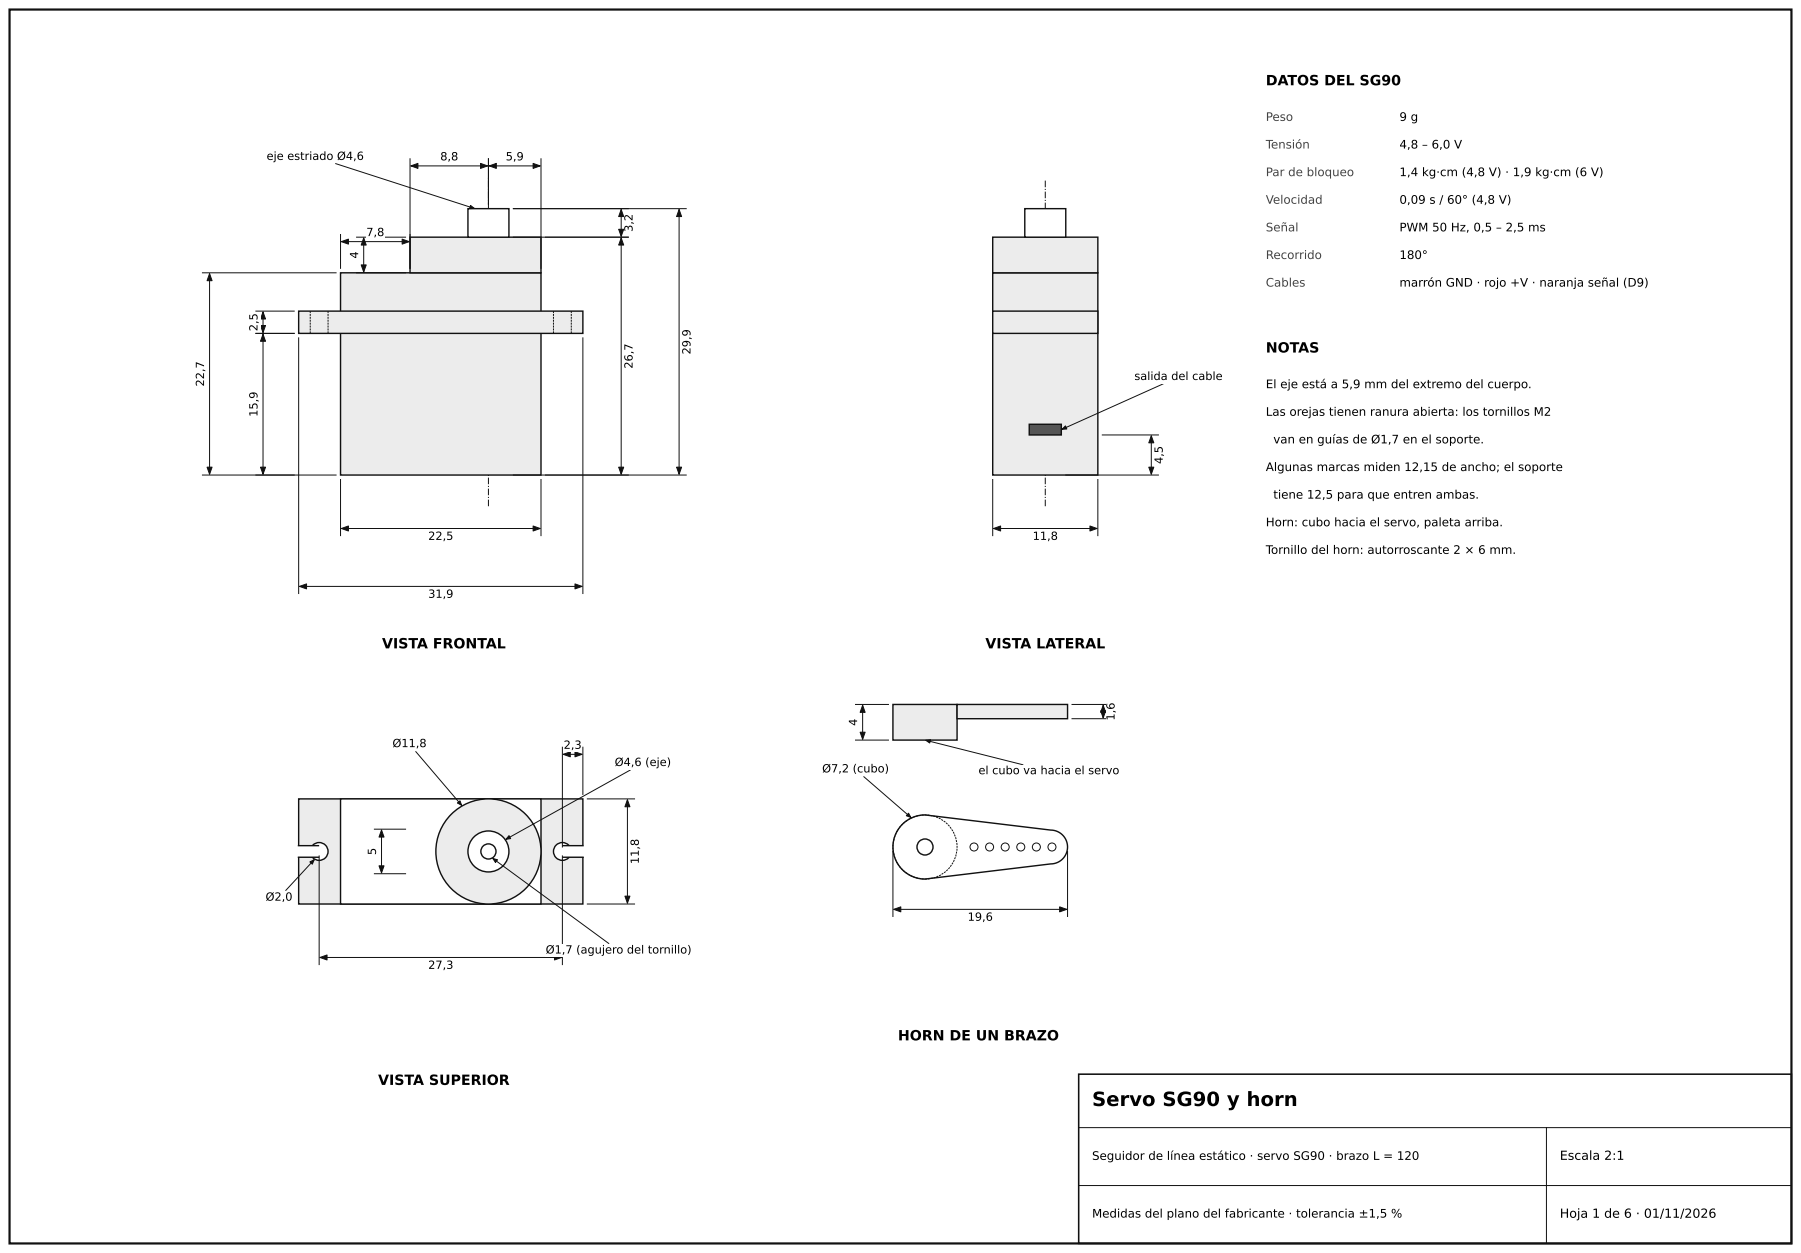
[picture p37: page 1]
Servo SG90 y horn; Escala 2:1; Hoja 1 de 6 · 01/11/2026; VISTA FRONTAL; VISTA SUPERIOR; VISTA LATERAL; Peso; Tensión; Par de bloqueo; Velocidad; Señal; PWM 50 Hz, 0,5 – 2,5 ms; Recorrido; Cables; marrón GND · rojo +V · naranja señal (D9); NOTAS; eje estriado Ø4,6; Ø4,6 (eje); Ø7,2 (cubo)

salida del cable

El eje está a 5,9 mm del extremo del cuerpo.

Las orejas tienen ranura abierta: los tornillos M2

van en guías de Ø1,7 en el soporte.

Algunas marcas miden 12,15 de ancho; el soporte

tiene 12,5 para que entren ambas.

Horn: cubo hacia el servo, paleta arriba.

Tornillo del horn: autorroscante 2 × 6 mm.

el cubo va hacia el servo

Ø1,7 (agujero del tornillo)

HORN DE UN BRAZO

Seguidor de línea estático · servo SG90 · brazo L = 120

Medidas del plano del fabricante · tolerancia ±1,5 %

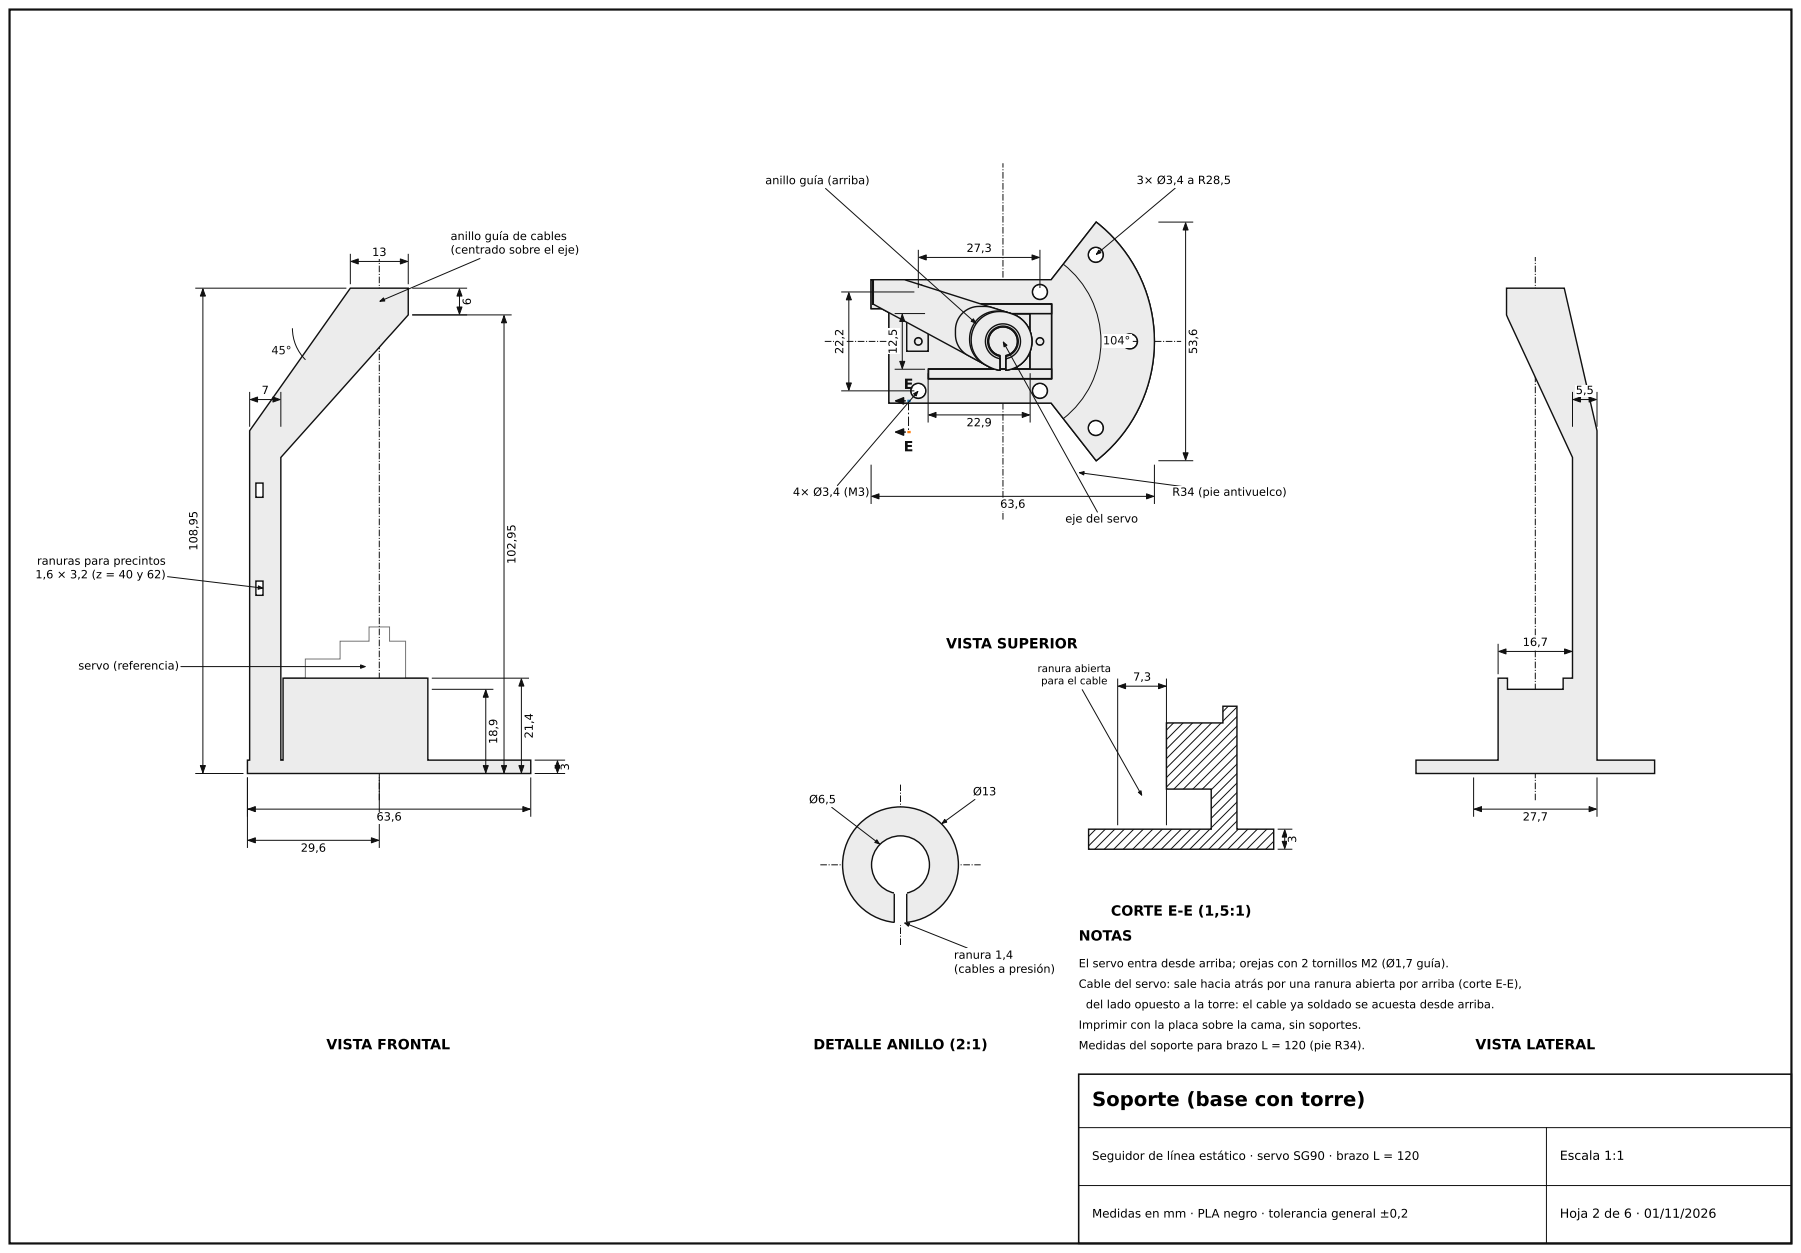
[picture p38: page 2]
Escala 1:1; Hoja 2 de 6 · 01/11/2026; VISTA FRONTAL; VISTA SUPERIOR; DETALLE ANILLO (2:1); VISTA LATERAL; CORTE E-E (1,5:1); NOTAS; servo (referencia); R34 (pie antivuelco); ranura 1,4 (cables a presión)

anillo guía (arriba)

anillo guía de cables
(centrado sobre el eje)

eje del servo

ranuras para precintos

ranura abierta
para el cable

El servo entra desde arriba; orejas con 2 tornillos M2 (Ø1,7 guía).
Cable del servo: sale hacia atrás por una ranura abierta por arriba (corte E-E),

del lado opuesto a la torre: el cable ya soldado se acuesta desde arriba.
Imprimir con la placa sobre la cama, sin soportes.
Medidas del soporte para brazo L = 120 (pie R34).

Soporte (base con torre)

Seguidor de línea estático · servo SG90 · brazo L = 120

Medidas en mm · PLA negro · tolerancia general ±0,2

143,3 ⁹,6

A

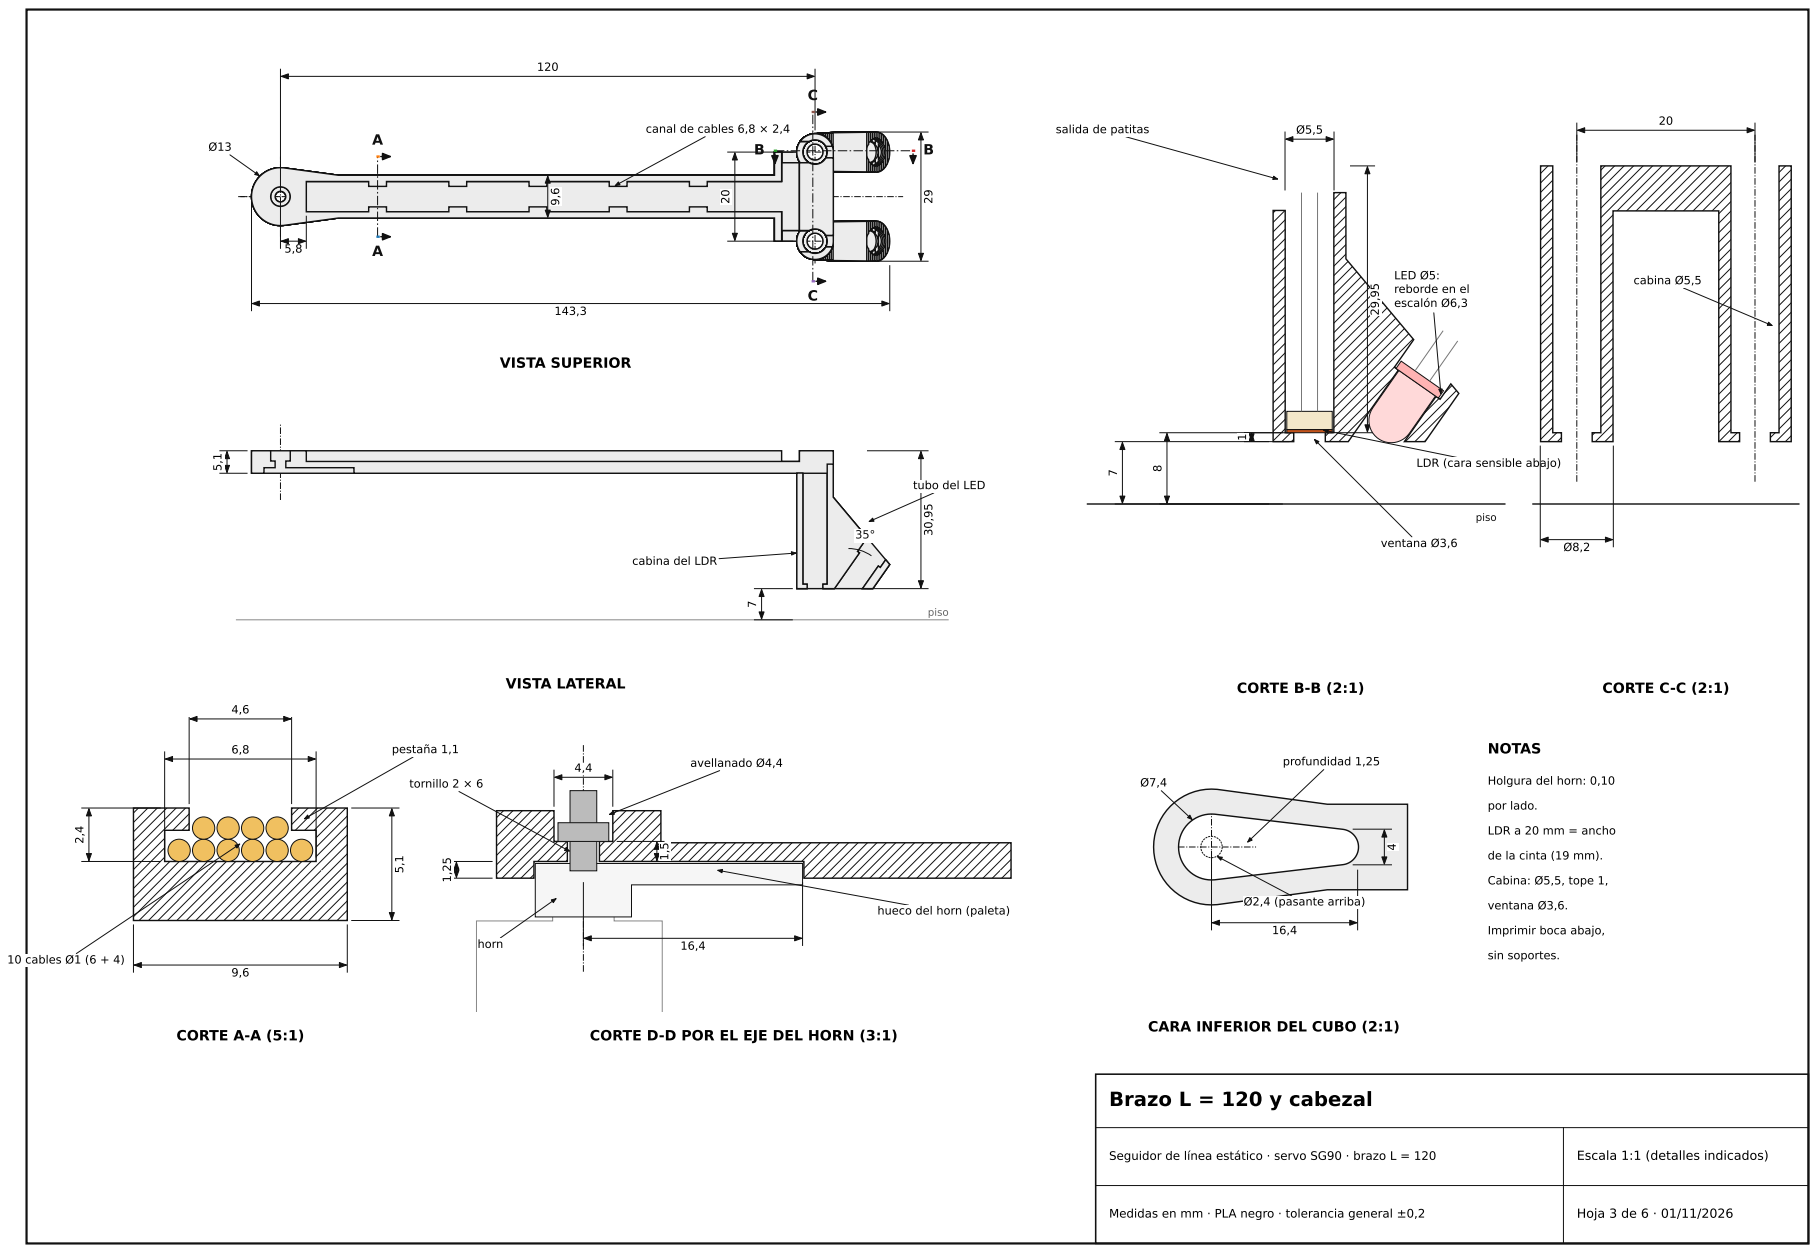
[picture p39: page 3]
Brazo L = 120 y cabezal; Hoja 3 de 6 · 01/11/2026; VISTA SUPERIOR; VISTA LATERAL; CORTE A-A (5:1); CORTE D-D POR EL EJE DEL HORN (3:1); CORTE B-B (2:1); CORTE C-C (2:1); NOTAS; por lado.; Cabina: Ø5,5, tope 1,; ventana Ø3,6.; sin soportes.; piso; pestaña 1,1; 10 cables Ø1 (6 + 4); horn; avellanado Ø4,4; tornillo 2 × 6; ventana Ø3,6; cabina Ø5,5; profundidad 1,25; Ø2,4 (pasante arriba)

canal de cables 6,8 × 2,4

salida de patitas

LED Ø5:
reborde en el
escalón Ø6,3

LDR (cara sensible abajo)

tubo del LED

cabina del LDR

Holgura del horn: 0,10

LDR a 20 mm = ancho

de la cinta (19 mm).

hueco del horn (paleta)

Imprimir boca abajo,

CARA INFERIOR DEL CUBO (2:1)

Seguidor de línea estático · servo SG90 · brazo L = 120

Escala 1:1 (detalles indicados)

## VISTA SUPERIOR · BARRIDO 60°–120° (escala 1:1,25)

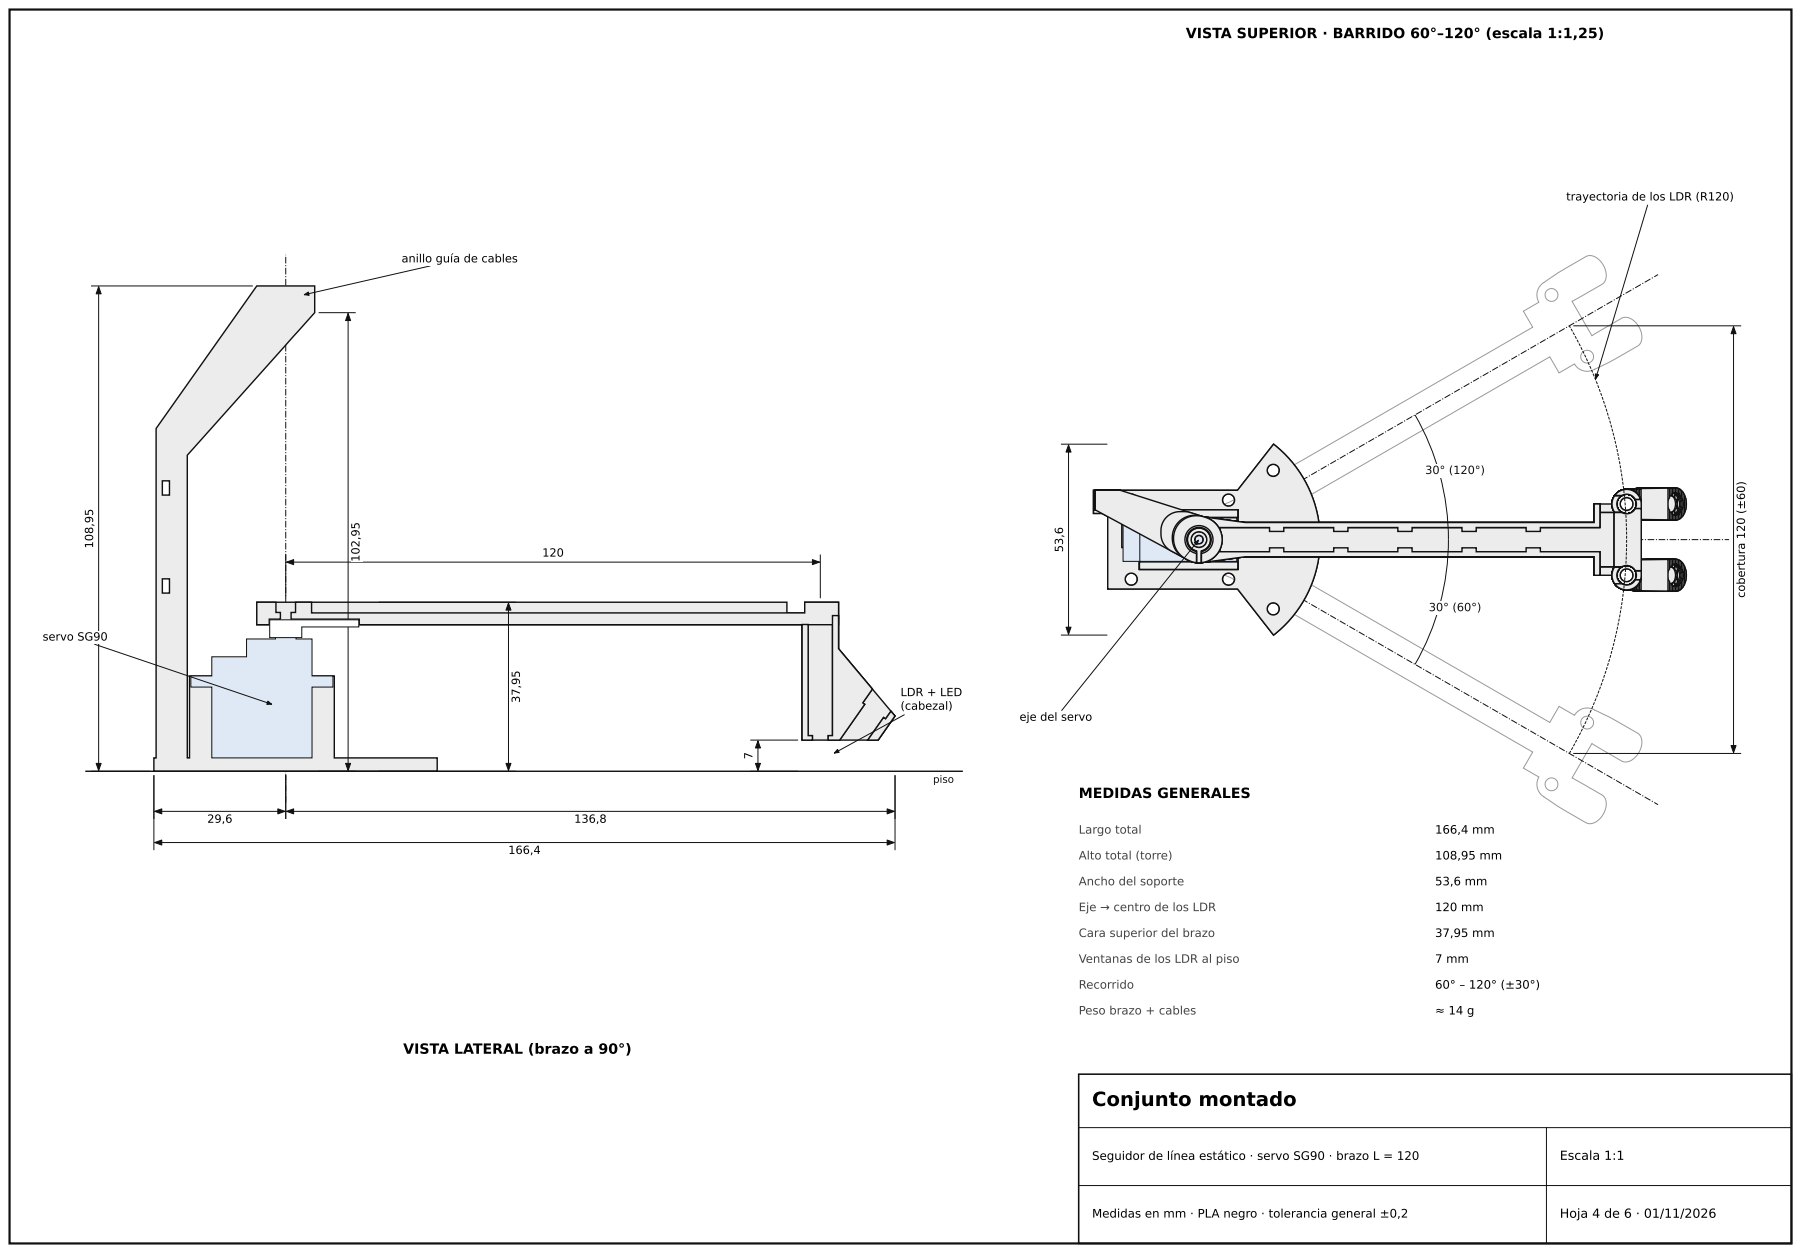
[picture p40: page 4]
Conjunto montado; Escala 1:1; Hoja 4 de 6 · 01/11/2026; MEDIDAS GENERALES; Largo total; Alto total (torre); Ancho del soporte; Eje → centro de los LDR; Cara superior del brazo; Ventanas de los LDR al piso; Recorrido; Peso brazo + cables; piso; servo SG90; LDR + LED (cabezal); cobertura 120 (±60)

trayectoria de los LDR (R120)

anillo guía de cables

eje del servo

VISTA LATERAL (brazo a 90°)

Seguidor de línea estático · servo SG90 · brazo L = 120

CABEZAL (en el brazo) | PLACA

## ARDUINO NANO

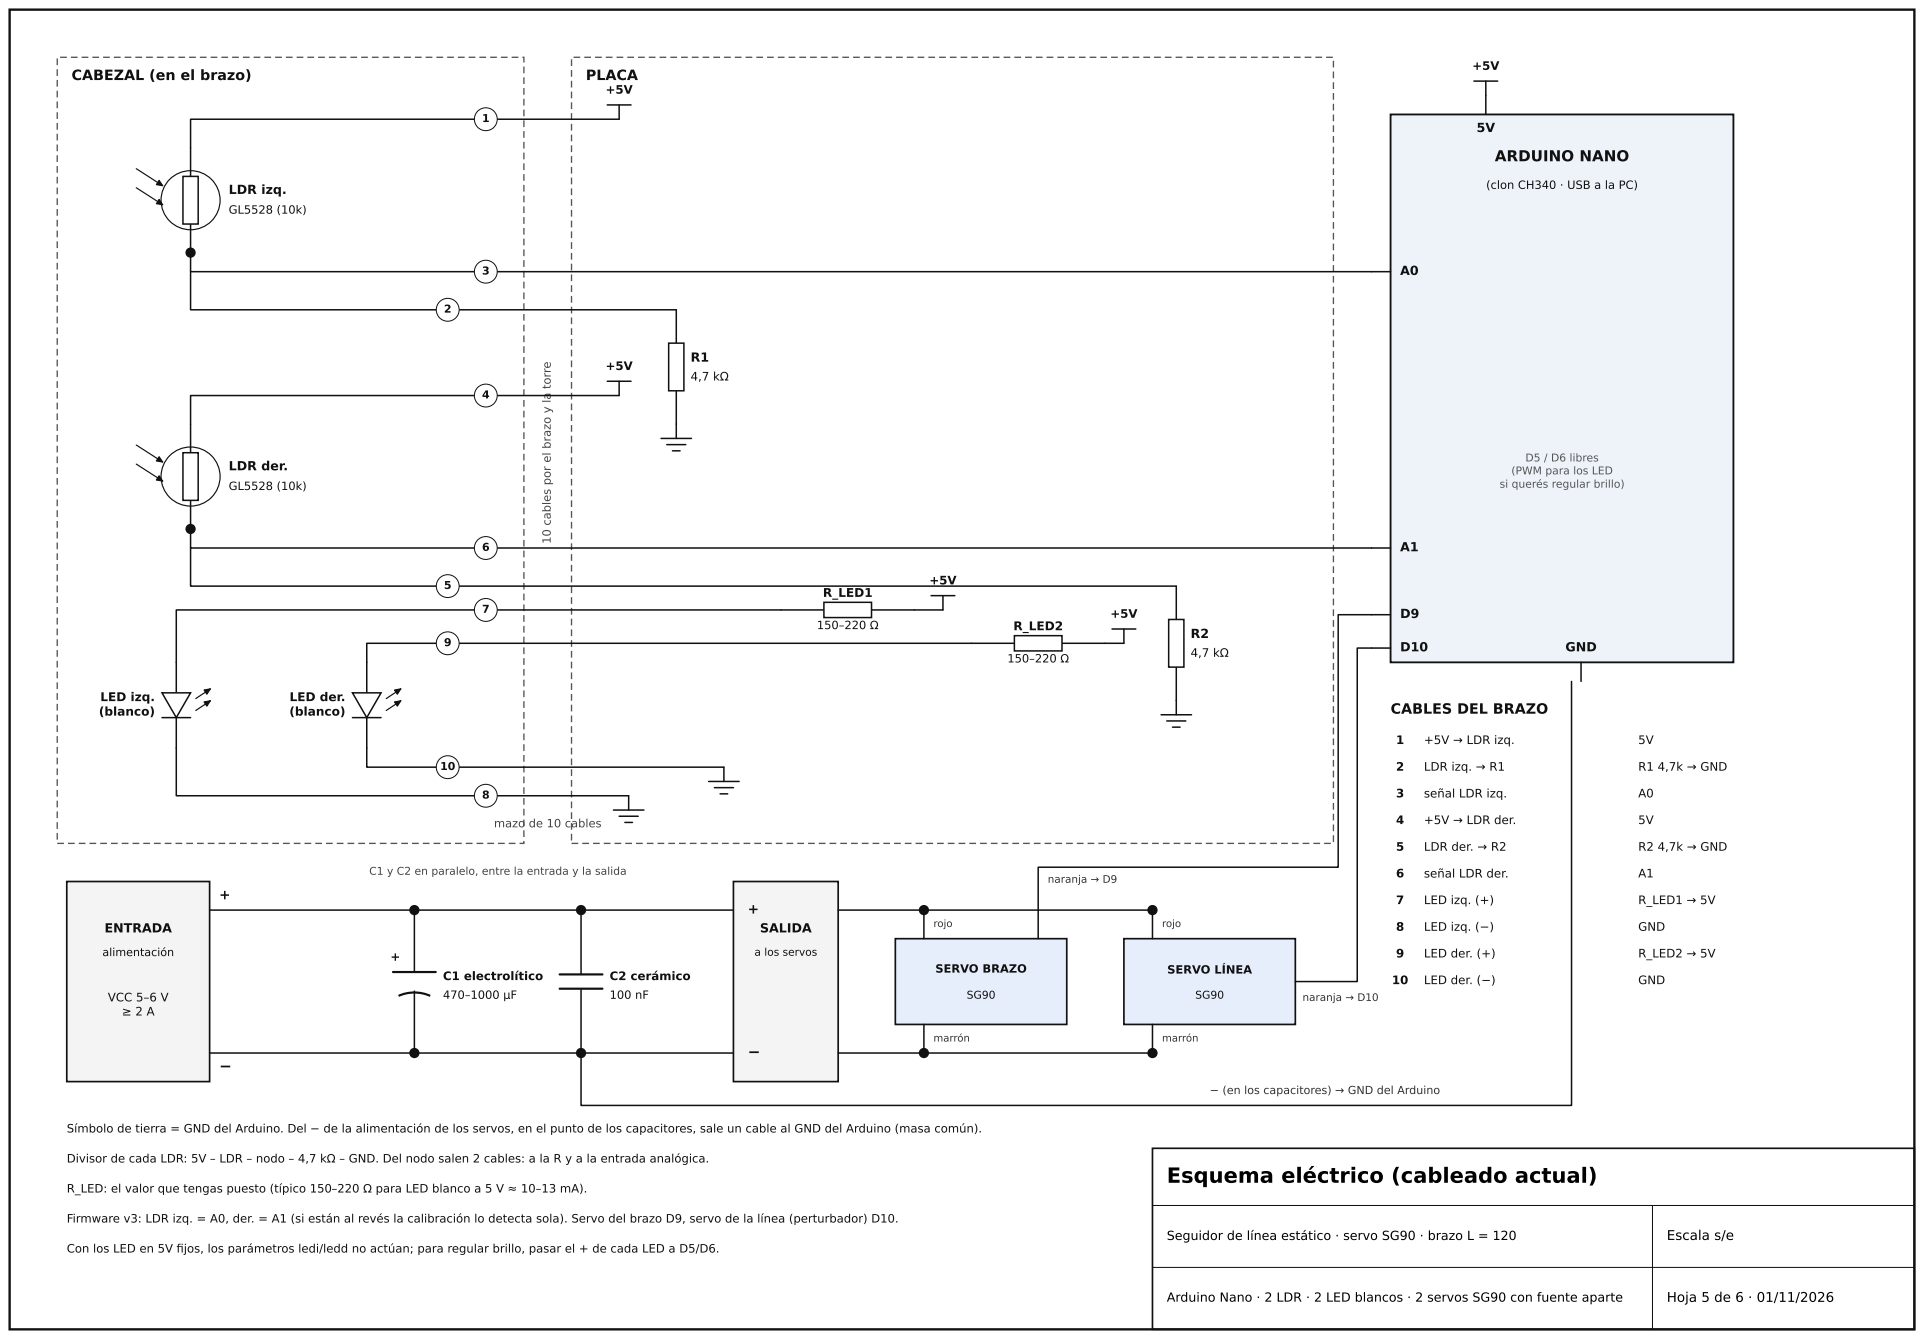
[picture p41: page 5]

(clon CH340 · USB a la PC)

10 cables por el brazo y la torre

D5 / D6 libres
(PWM para los LED
si querés regular brillo)

C1 y C2 en paralelo, entre la entrada y la salida

− (en los capacitores) → GND del Arduino

Símbolo de tierra = GND del Arduino. Del − de la alimentación de los servos, en el punto de los capacitores, sale un cable al GND del Arduino (masa común).

Divisor de cada LDR: 5V – LDR – nodo – 4,7 kΩ – GND. Del nodo salen 2 cables: a la R y a la entrada analógica.

R_LED: el valor que tengas puesto (típico 150–220 Ω para LED blanco a 5 V ≈ 10–13 mA).

Esquema eléctrico (cableado actual)

Firmware v3: LDR izq. = A0, der. = A1 (si están al revés la calibración lo detecta sola). Servo del brazo D9, servo de la línea (perturbador) D10.

Seguidor de línea estático · servo SG90 · brazo L = 120

Con los LED en 5V fijos, los parámetros ledi/ledd no actúan; para regular brillo, pasar el + de cada LED a D5/D6.

Arduino Nano · 2 LDR · 2 LED blancos · 2 servos SG90 con fuente aparte

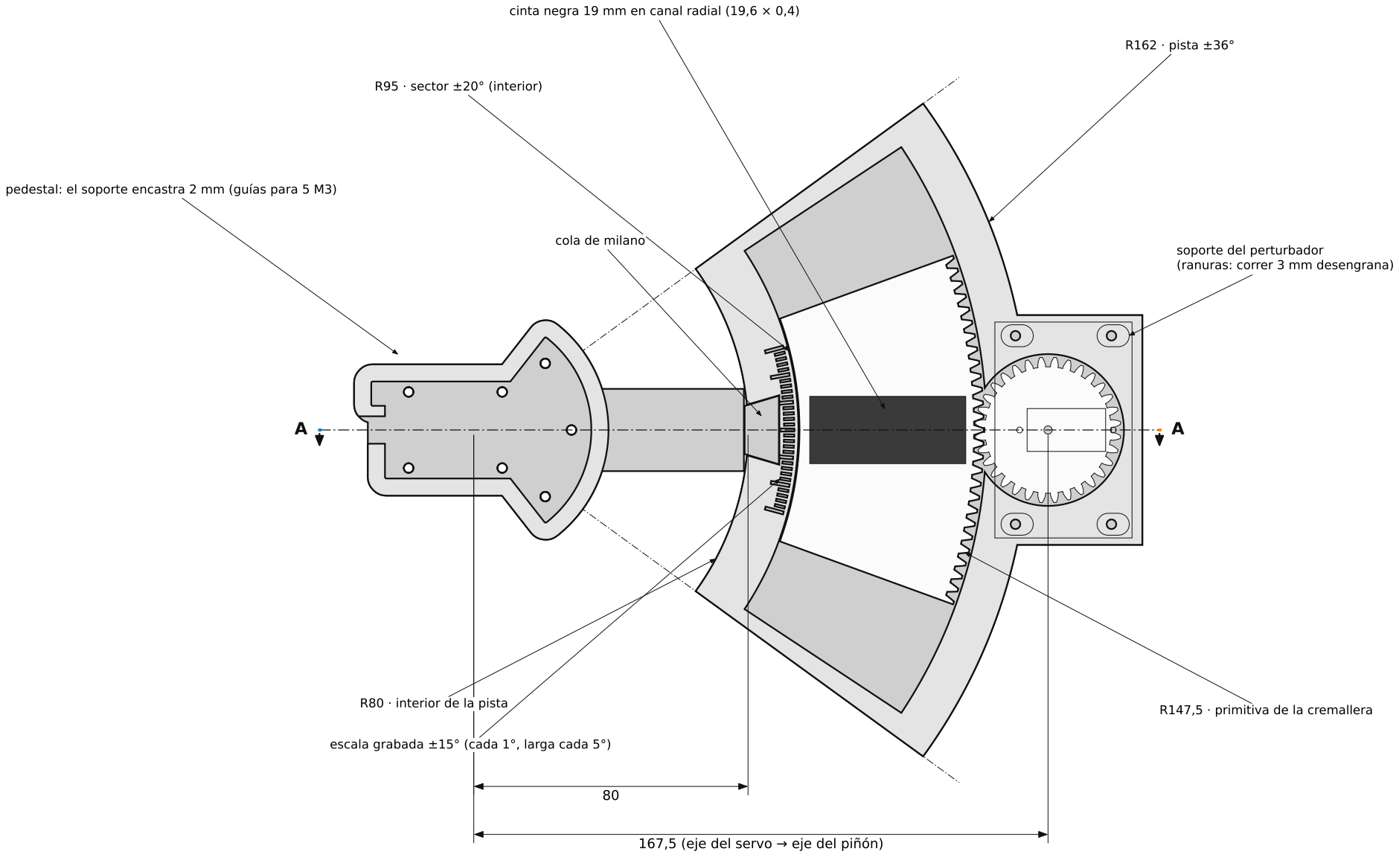
[picture p42: figure]
167,5 (eje del servo → eje del piñón); R162 · pista ±36°; R95 · sector ±20° (interior); cola de milano; soporte del perturbador (ranuras: correr 3 mm desengrana)
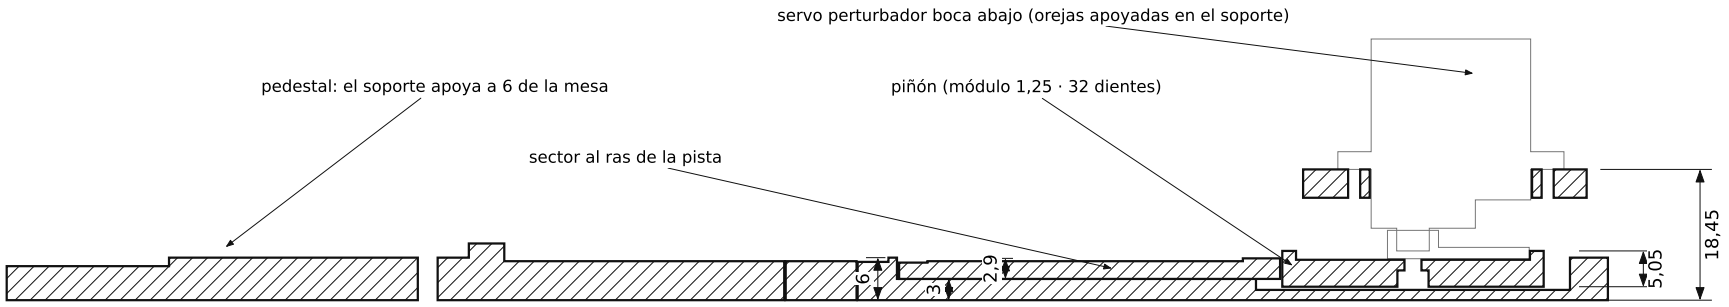
[picture p43: figure]
piñón (módulo 1,25 · 32 dientes); sector al ras de la pista

# Plataforma de la línea y perturbador

Seguidor de línea estático · servo SG90 · brazo L = 120

Medidas en mm · pista y sector en PLA blanco mate · resto PLA negro

Escala 1:1,5 (detalles indicados)

Hoja 6 de 6 · 01/11/2026

## VISTA SUPERIOR (1:1,5)

## PIÑÓN (1,5:1)

## CORTE A-A (1:1)

## PIEZAS

P1 pedestal | 123,9 × 64 × 8 | negro | 33 g
P2 pista | 130,3 × 190,4 × 6 | blanco | 71 g
P3 sector | 59,5 × 101,8 × 2,9 | blanco | 15 g
P4 piñón | 42,4 × 42,4 × 5,1 | negro | 7 g
P5 soporte | 40 × 63 × 12,5 | negro | 15 g

## ENGRANAJE

Módulo / presión | 1,25 / 20°
Cremallera (sector) | 236 dientes virtuales, R 147,5
Piñón | | 32 dientes, Ø primitivo 40
Relación | 7,375 : 1
1° de servo | 0,136° de línea
Recorrido (servo 0–180°) | ±12,2° de línea
Juego entre dientes | 0,15 mm

## NOTAS

La superficie de la línea queda a 6 mm de la mesa: el soporte

sube lo mismo (encastrado en el pedestal) y los LDR siguen

a 7 mm de la superficie.

Armado del perturbador: piñón al horn y tornillo 2×6 desde abajo

con el soporte fuera de la pista; después bajar el soporte

engranando y atornillar (M3) por las ranuras.

Cero, relación y sentido: «Calibrar el perturbador» (calp).

Pista y sector en blanco mate: son la superficie que ven los LDR.

R147,5 · primitiva de la cremallera R80 · interior de la pista cinta negra 19 mm en canal radial (19,6 × 0,4)

escala grabada ±15° (cada 1°, larga cada 5°)

pedestal: el soporte encastra 2 mm (guías para 5 M3)

Ø42,5

Ø40 prim.

8

servo perturbador boca abajo (orejas apoyadas en el soporte)

pedestal: el soporte apoya a 6 de la mesa
