sebastiandure33-crypto/Banco-de-pruebas-PID-v2/(commit log)

2026-11-01 Proyecto inicial: diseño 3D, planos, firmware v2 y panel
    - 1_DISENO_3D: STL para imprimir con instrucciones, variantes, modelo paramétrico,
    imágenes y cálculos
    - 2_PLANOS: planos A3 acotados y esquema eléctrico, con su fuente
    - 3_FIRMWARE_Y_PANEL: firmware v2, .hex, panel Web Serial y simulación
    Claude-Session: https://claude.ai/code/session_019YScGqjzvyQfas5N8yyFFC
    [01_brazo_L120.stl, 02_base_L120.stl, base_apoyo_libre_L100.stl, base_apoyo_libre_L120.stl, base_apoyo_libre_L150.stl, base_compacta_atornillar.stl, brazo_L100.stl, brazo_L120.stl]
2026-11-01 Banco de pruebas PID v3: plataforma con perturbador, firmware y panel nuevos
    - 1_DISENO_3D: plataforma de la línea (pedestal, pista, sector con cremallera,
    piñón y soporte del servo perturbador), modelo plataforma.py con verificación,
    STL para imprimir (pista y sector en blanco), instrucciones e imágenes
    - 2_PLANOS: hoja 6 de la plataforma; esquema con los dos servos (D9 y D10)
    - 3_FIRMWARE_Y_PANEL: firmware banco_pid_v3 (P/PI/PD/PID, interruptores,
    corrección de LDR, calibración del perturbador, ensayos guiados), panel v3
    reorganizado por pestañas con métricas y comparación, simulación con 31
    chequeos; la v2 queda en anteriores/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
    [03_pedestal.stl, 04_pista_BLANCO.stl, 05_sector_linea_BLANCO.stl, 06_pinon.stl, 07_soporte_perturbador.stl, P1_pedestal.stl, P2_pista.stl, P3_sector_linea.stl]
2026-11-02 Piñón del perturbador: acepta horn de un brazo, recto o en cruz
    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
    [06_pinon.stl, P4_pinon.stl]
